fisher55rus/Invertor/Fragments/Литра1.jpg

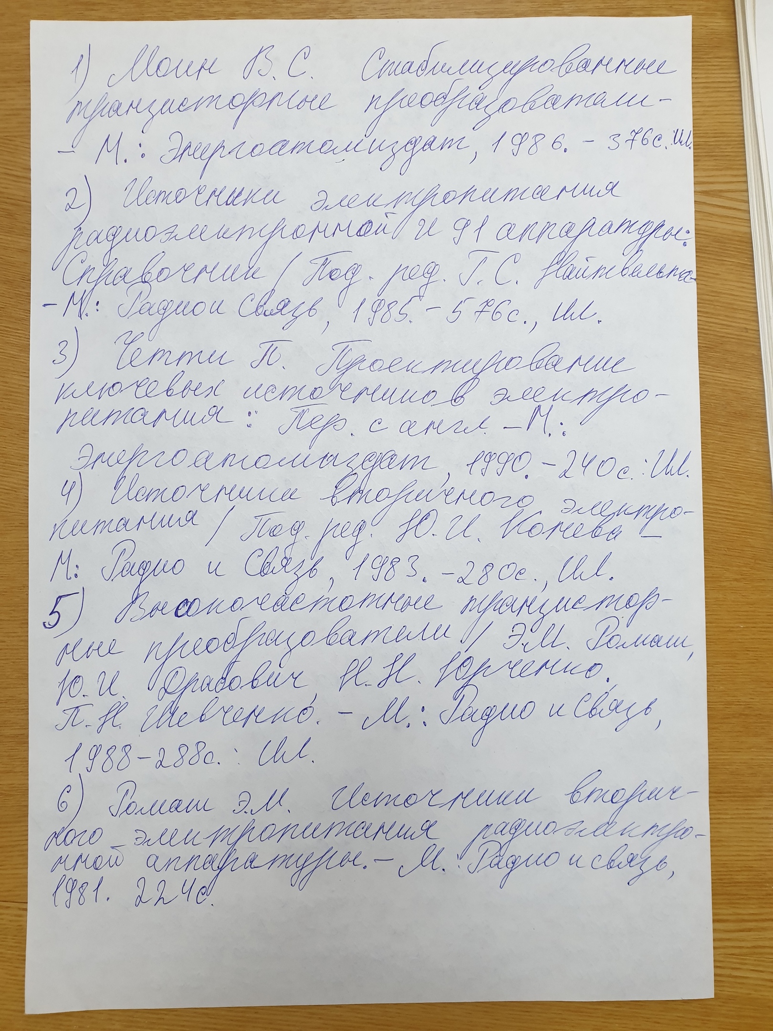
Fragments/Литра1.jpg
