fisher55rus/Invertor/Fragments/Литра2.jpg

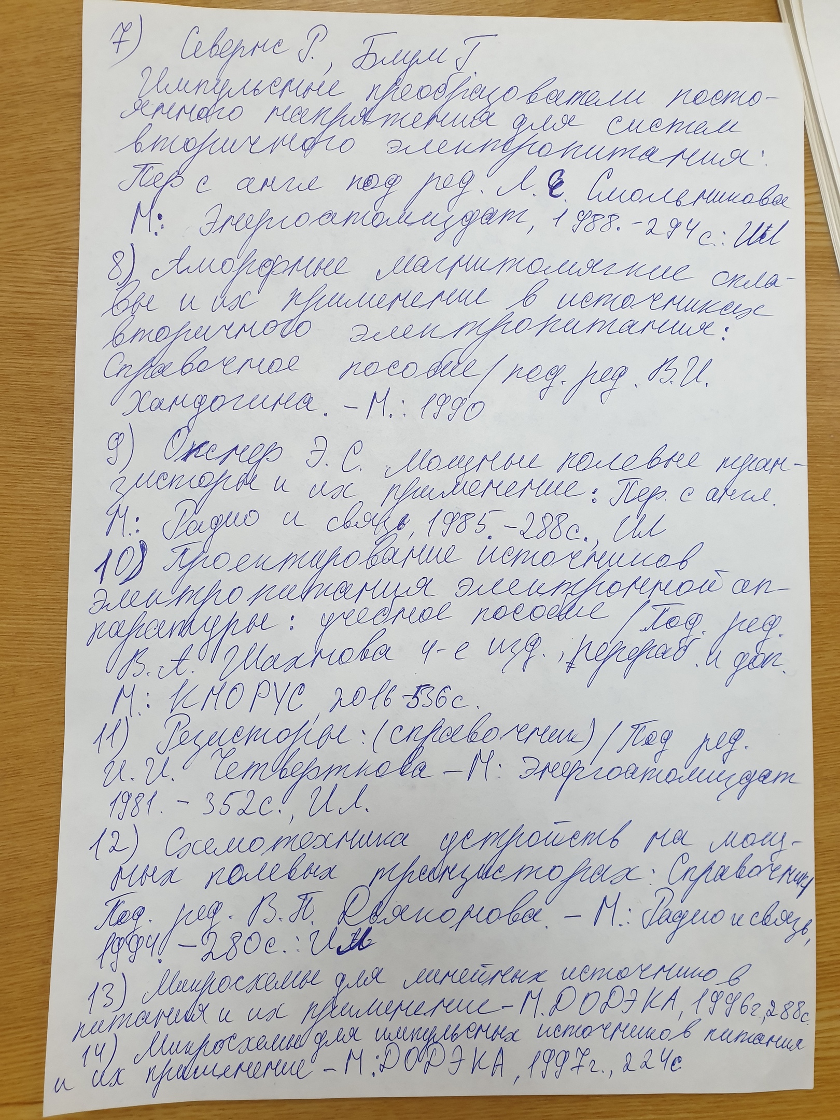
Fragments/Литра2.jpg
