fisher55rus/Invertor/template/main.pdf

Оглавление

Разработка структурной схемы однофазного транзисторного инвертора с гальванической

Список терминов и сокращений

ВЧ трансформатор – Высокочастотный трансформатор НЧ трансформатор – Низкочастотный трансформатор ИВЭП – Источник вторичного электропитания
БВН – Блок вспомогательного напряжения
ДВН – Датчик выходного напряжения
СУЗ – Схема управления и защиты
ДТ – Датчик тока
ИОСН – Источник опорного синусоидального напряженния РНП– Регулятор напряжения питания
РИУ – Регулятор импульсного управления
УСР – Усилитель сигнала рассогласования ОС – Обратная связь

Введение

Возрастающие требования к функциональным возможностям, экономичности и надежности летательных аппаратов диктуют необходимость разработки и внедрения автоматизированных бортовых комплексов,
использующих | новейшие | достижения | силовой | электроники | и
микроэлектроники. В области авиационного электрооборудования - это системы, основанные на преобразовании и распределении электрической
энергии | с | помощью | полупроводниковых | ключей.
В составе таких комплексов важное место отводится инверторам.

Инвертор – Один из видов ИВЭП. Устройство для преобразования постоянного напряжения в выходное переменное. При построении инвертора в приоритете повышение КПД и уменьшение потерь.

Требования к инвертору:

- Инвертор должен иметь высокий КПД
- Инвертор должен уменьшать потери
- Инвертор должен обладать высокой надежностью
- Инвертор должен обладать приемлемыми массо-габаритными характеристиками
- Инвертор должен иметь допустимое значение коэффициентов гармоники

Классификация инверторов:

1. Однофазные:
- С гальванической развязкой:
- С ВЧ трансформатором
- С НЧ трансформатором
-Без гальванической развязки
2. Трехфазные
3. С управлением по напряжению
4. С управлением по току
5. С ШИМ регулированием
6. С РИМ регулированием
7. С аналого-цифровым управлением
8. С микроконтроллерным управлением
9. Одноуровневые
10.Многоуровневые
11.Транзисторные
12.Терристорные

Выбор зависит от конкретных исходных данных и требований. Каждый из перечисленных типов инверторов имеет свои “плюсы” и “минусы”.

Исходя из технических требований, так как в приоритете работы инвертора повышение КПД и снижение потерь, сделан инвертор в ключевом режиме с импульсным методом преобразования.

В процессе создания пришлось использовать сглаживающие силовые фильтры ФНЧ. Благодаря им удалось пропустить первую гармонику, а остальные профильтровать (подавить).

Разработка структурной схемы однофазного транзисторного инвертора с гальванической развязкой

Исходные данные:

- Uвх = 27 В (18 Вmin-36 Вmax)
- Uвых = 36 В ± 2%
- Pнагр = 250 Вт
- cosφ ≥ 0,8
- Uвых пост ≤ 0,5%
- Ограничение аварийных и переходных токов Pнmax = 1,5*Pнагр
- Коэффициент гармоник Кг ≤ 7%

Алгоритм работы структурной схемы и особенности ее построения

Для переключения ключей СТК используется второй импульсный режим. Ключи включаются по диагонали одновременно и синфазно. Такой алгоритм работы структурной схемы обеспечивает простую схему управления и низкую частоту переключения, что позволяет использовать маленький радиатор и тем самым уменьшить массу устройства.

Фильтр разбит на 2 части. В СТК находится дроссель L, т.к. там большой ток, а перед нагрузкой находится конденсатор С, т.к. там большое напряжение. L фильтра – двухобмоточная.

Структурная схема ивертора

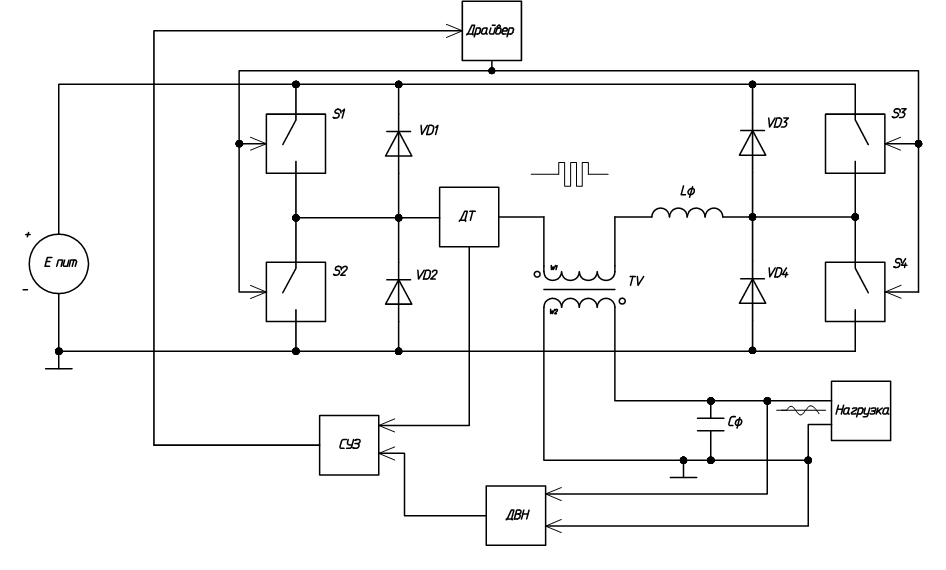
[picture p27: figure]

Рисунок 1 – Структурная схема инвертора

Где :

СУЗ – Схема управления и защиты;

ДВН – Датчик выходного напряжения;

ДТ – Датчик тока.

Разработка функциональной схемы силового каскада

В схеме СТК используются драйверы, которые не требуют подпитки от БВН, это позволяет уменьшить массу устройства.

Из нескольких видов датчиков тока:

- Резистивный
- На эффекте Холла (отечественных датчиков нет)
- Трансформаторный

был выбран последний.

Внутри МДП транзисторов присутствуют паразитные диоды, благодаря им можно обойти без обратных диодов. Но т.к. их параметры плохие, они могут привести к ЭМС и большим потерям. Следовательно, было принято решение поставить диоды шотки. При закрытии транзистора, тока из катушки индуктивности пойдет по пути наименьшего сопротивления через диоды шотки.

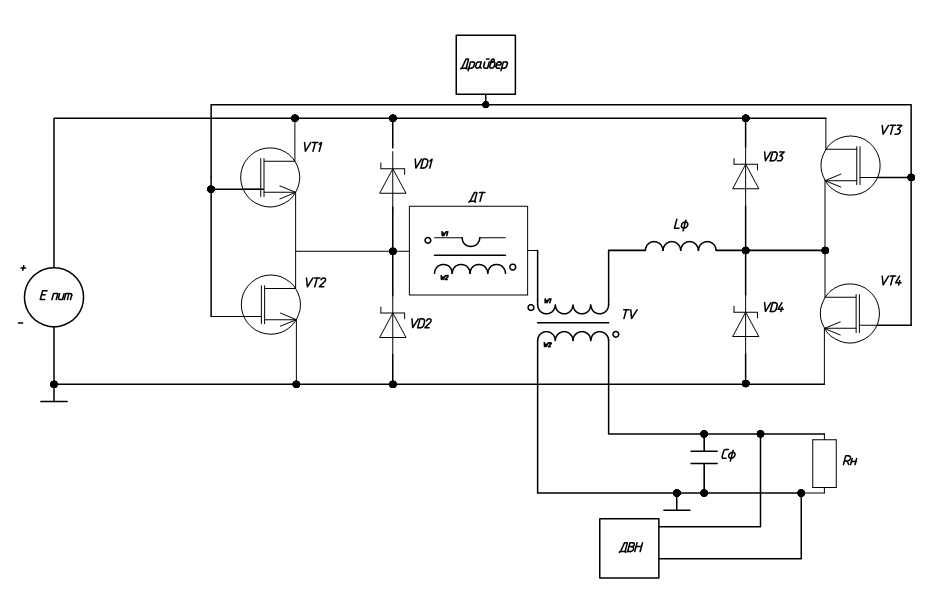
[picture p28: figure]

Рисунок 2 – Функциональная схема СТК

Разработка структурной схемы СУЗ

Существует множество способов построения схемы управления и защиты. В данной курсовой работе был выбран: СУЗ с реллейно-импульсной модуляцией и ограничением по току.

Элементы схемы:

- Сумматор (создает рассогласование напряжения между опорой и синусом)
- Ограничитель напряжения (ограничивает напряжение от -1 до +1)
- Релле (переключает транзисторы)
- ИНСН (дает опорное синусоидальное напряжение)
- ДВН (датчик входного напряжения)

-ДТ (датчик тока)

- УСР (усиливает согнал рассогласования)
- РНП (регулирует напряжения питания)
- РИУ (регулирует импульсное управление)

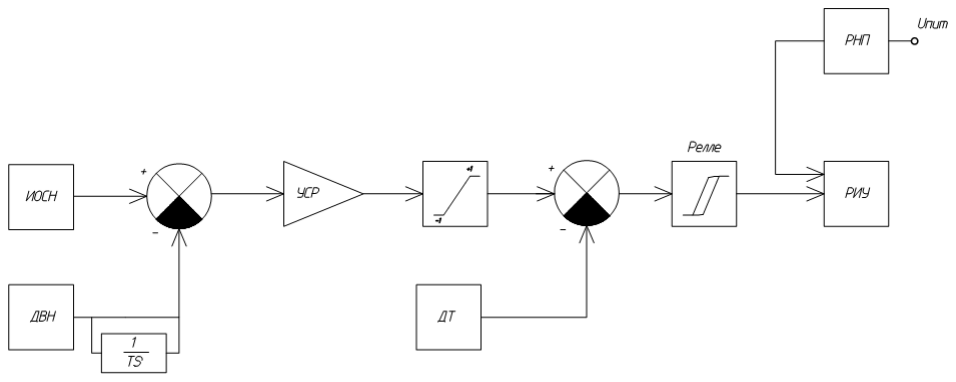
[picture p29: figure]

Рисунок 3 – Структурная схема СУЗ

Построение источника опорного синусоидального напряжения

Есть несколько способов получения ИОСН:

- Однополярный микроконтроллер + схема для второй полярности
- Мультивибратор + фильтр
- Синусный генератор

Был выбран последний вариант.

Из-за того, что ВАХ диода очень зависит от температуры, для схемы выбраны прецезионные и термостабильные диоды.

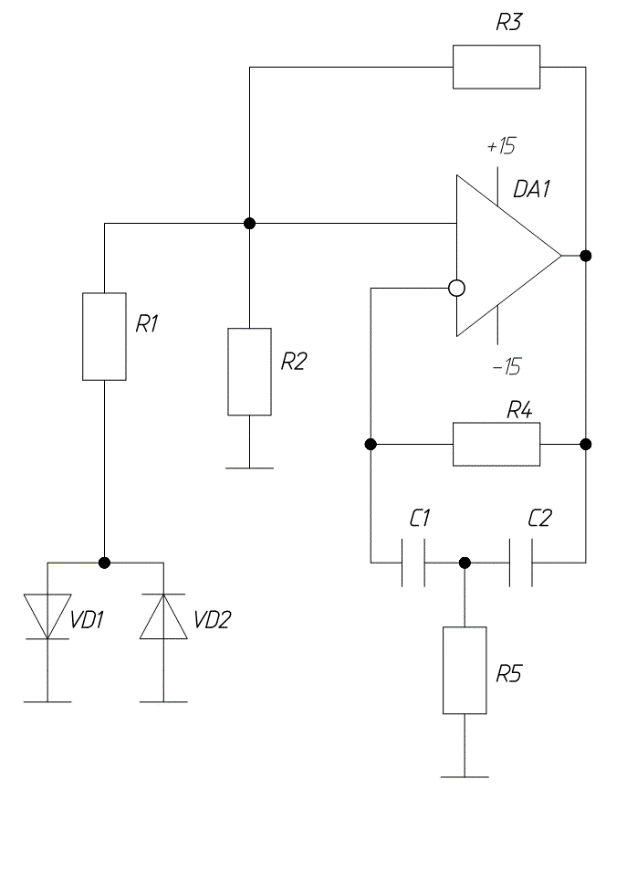
[picture p30: figure]

Рисунок 4 – Схема ИОСН

Математические расчеты

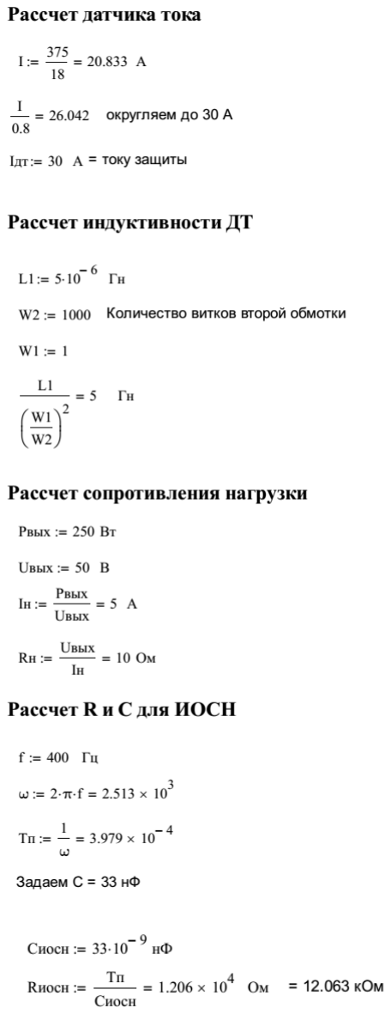
[picture p31: figure]

Моделирование и результаты

В среде Pspice OrCAD была создана модель синусоидального опорного напряжения.

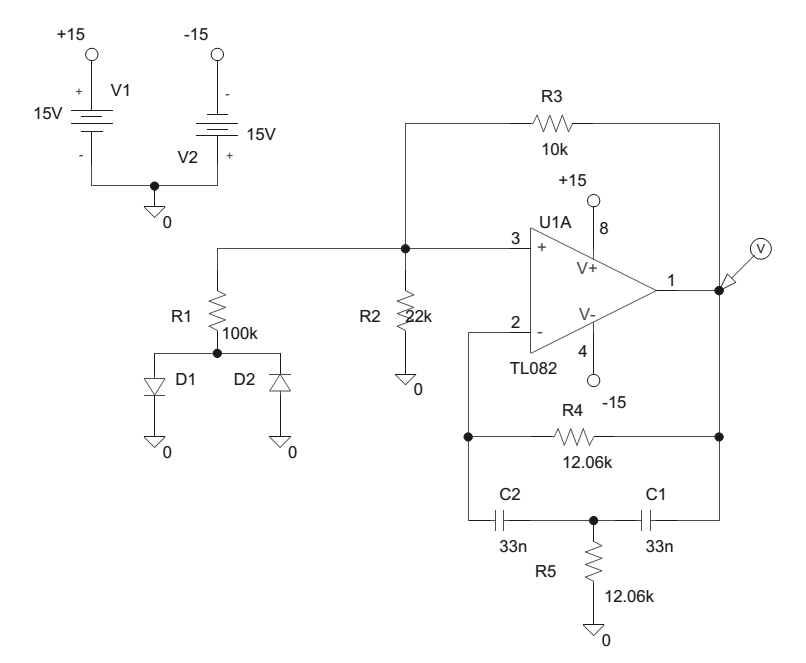
[picture p32: figure]

Рисунок 5 – Схема Pspice источника опорного синусоидального напряжения

ИОСН выполнен как звено с незатухающими синусными колебаниями. Переходные процессы в RC цепочке (R4,C2,C1) образуют синус. При значении коэффициента > 1, колебания будут нарастать, при значении < 1 колебания будут затухать. По этой причине к схеме была пристроена обратная связь. Положительная обратная связь позволяет замкнутой системе работать в режиме генератора. Рассчитанные значения элементов (R1, R2, R3) в ОС умножают коэффициент на 2/3, что и позволяет получить незатухающие колебания.

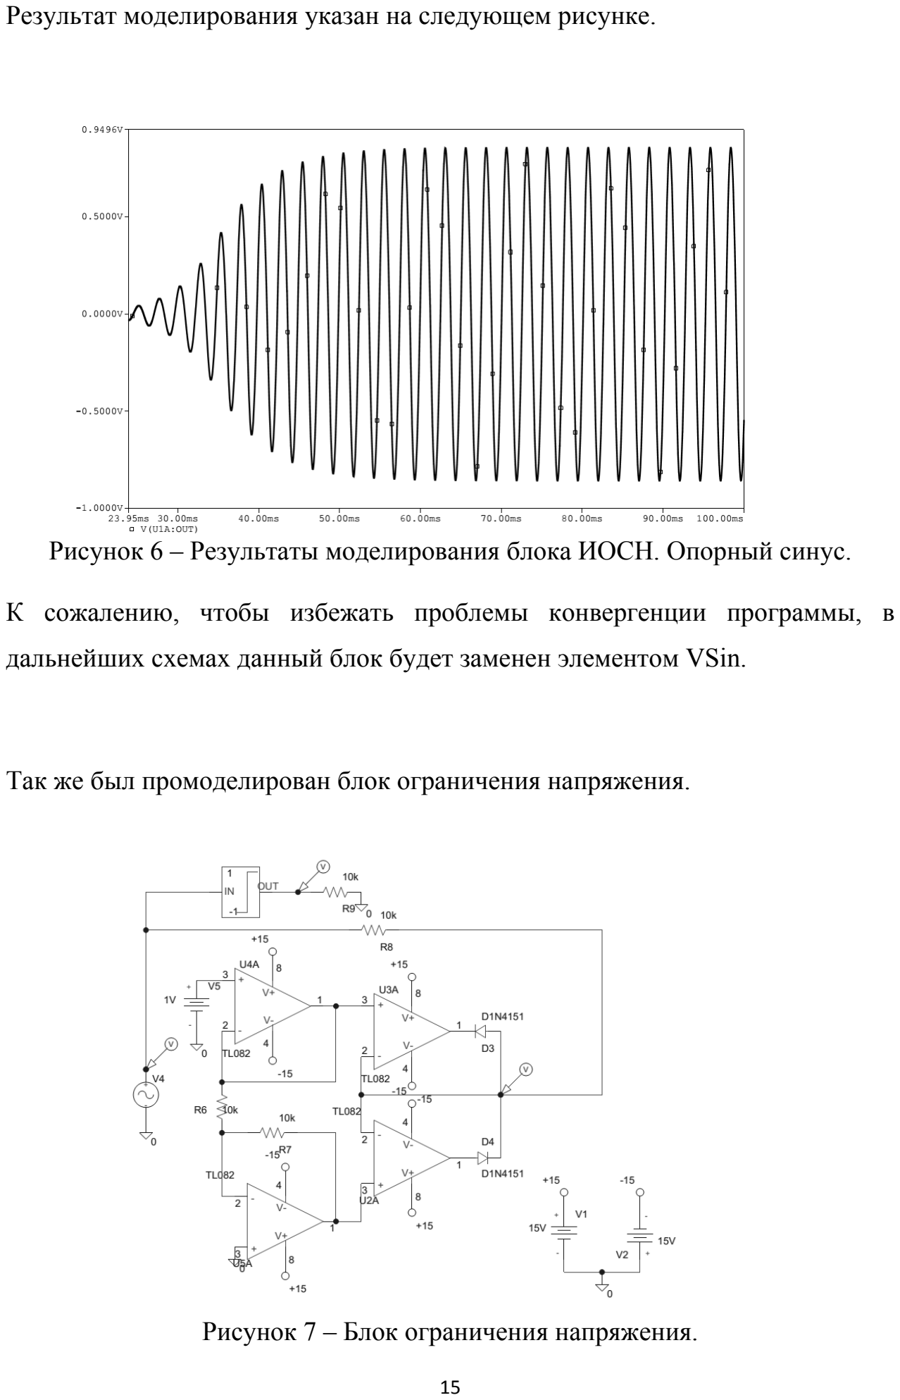
[picture p33: page 15]

Результат моделирования указан на следующем рисунке.

Рисунок 6 – Результаты моделирования блока ИОСН. Опорный синус.

К сожалению, чтобы избежать проблемы конвергенции программы, в дальнейших схемах данный блок будет заменен элементом VSin.

Так же был промоделирован блок ограничения напряжения.

Рисунок 7 – Блок ограничения напряжения.

В данной схеме, микросхемы U4A и U5A создают уровни напряжения +1В и -1В. Они поступают на положительные входы микросхем U3A и U2A, на инверсные входы которых приходит синусоидальный сигнал с элемента VPULSE. При ограничении синусоидального сигнала уровнями “+1В” и “-1В”, получается прямоугольный сигнал, показанный на рисунке 8.

Элемент Limit на представленной схеме выполняет роль проверки. Чтобы сравнить эффективность построенной схемы с готовым элементом. Результаты предоставлены ниже.

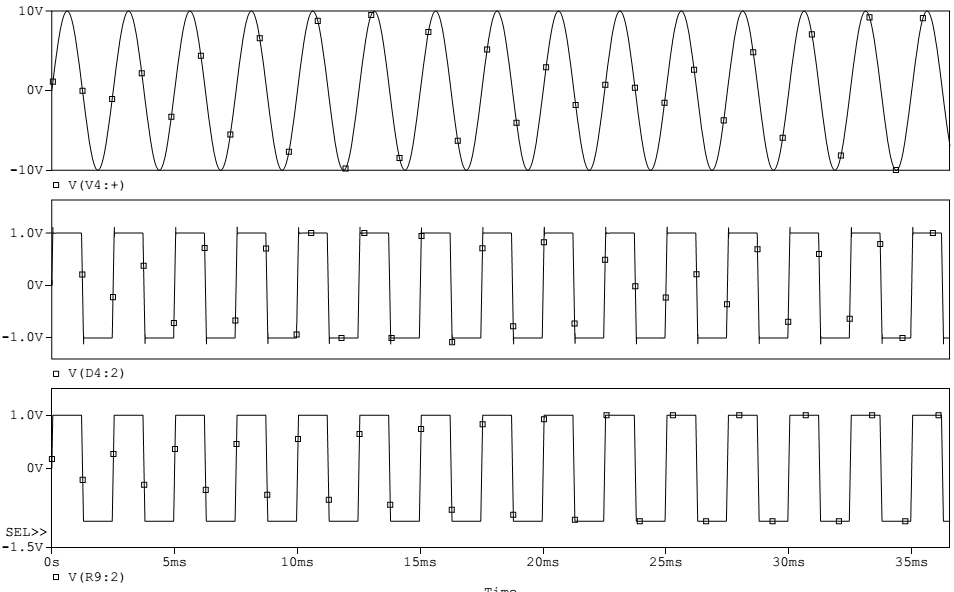
[picture p34: figure]

Рисунок 8 – Результаты моделирования блока ограничения напряжения

На первом графике представлен исходный синус, на втором графике результат ограничения схемой, а на третьем результат ограничения готовым элементом.

Схема работает исправно. Но чтобы исключить появление конвергенции в программе, в дальнейших схемах будет использоваться элемент Limit.

Было решено делать трансформаторный драйвер, т.к. он не требует подпитки от БВН. Такой драйвер выполняет две функции:

- Передача сигнала.
- Передача энергии самоподпитки.

Так же отдельно была создана схема драйвера, не требующая подпитки от БВН.

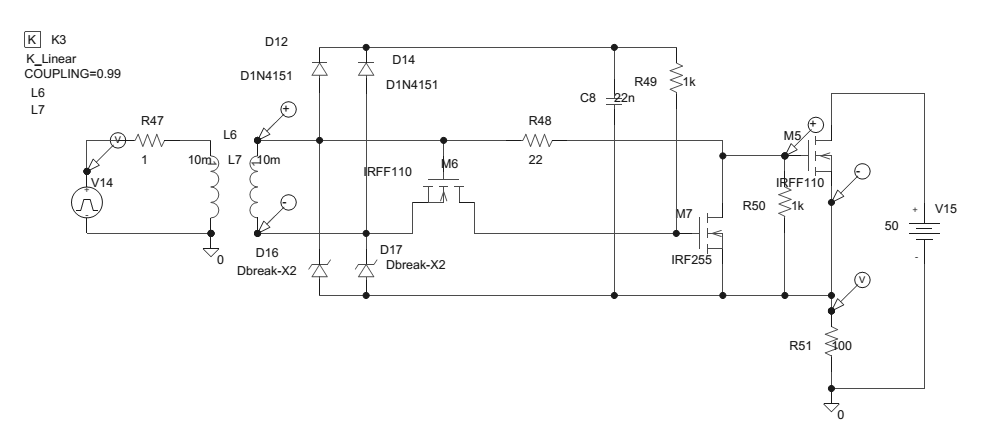
[picture p35: figure]

Рисунок 9 – Схема драйвера без схемы управления

В левой части модели трансформаторного драйвера находится его схема управления, замененная элементом VPULSE. Ток из нее поступает на первичную обмотку трансформатора L6 и не меняясь переносится на вторичную обмотку L7. Сигнал следуя от точки “+” катушки L7 открывает силовой транзистор М5. В момент, когда транзистор СТК будет закрыт, открывается транзистор М7 и ток возвращается через открытый транзистор М6 на точку “-” катушки L7.

На месте диодов D16 и D17, необходимо поставить два стабилитрона. Иначе, при значение COUPLING =0.99 (неидеальная передача), напряжение на силовом транзисторе сильно испортится.

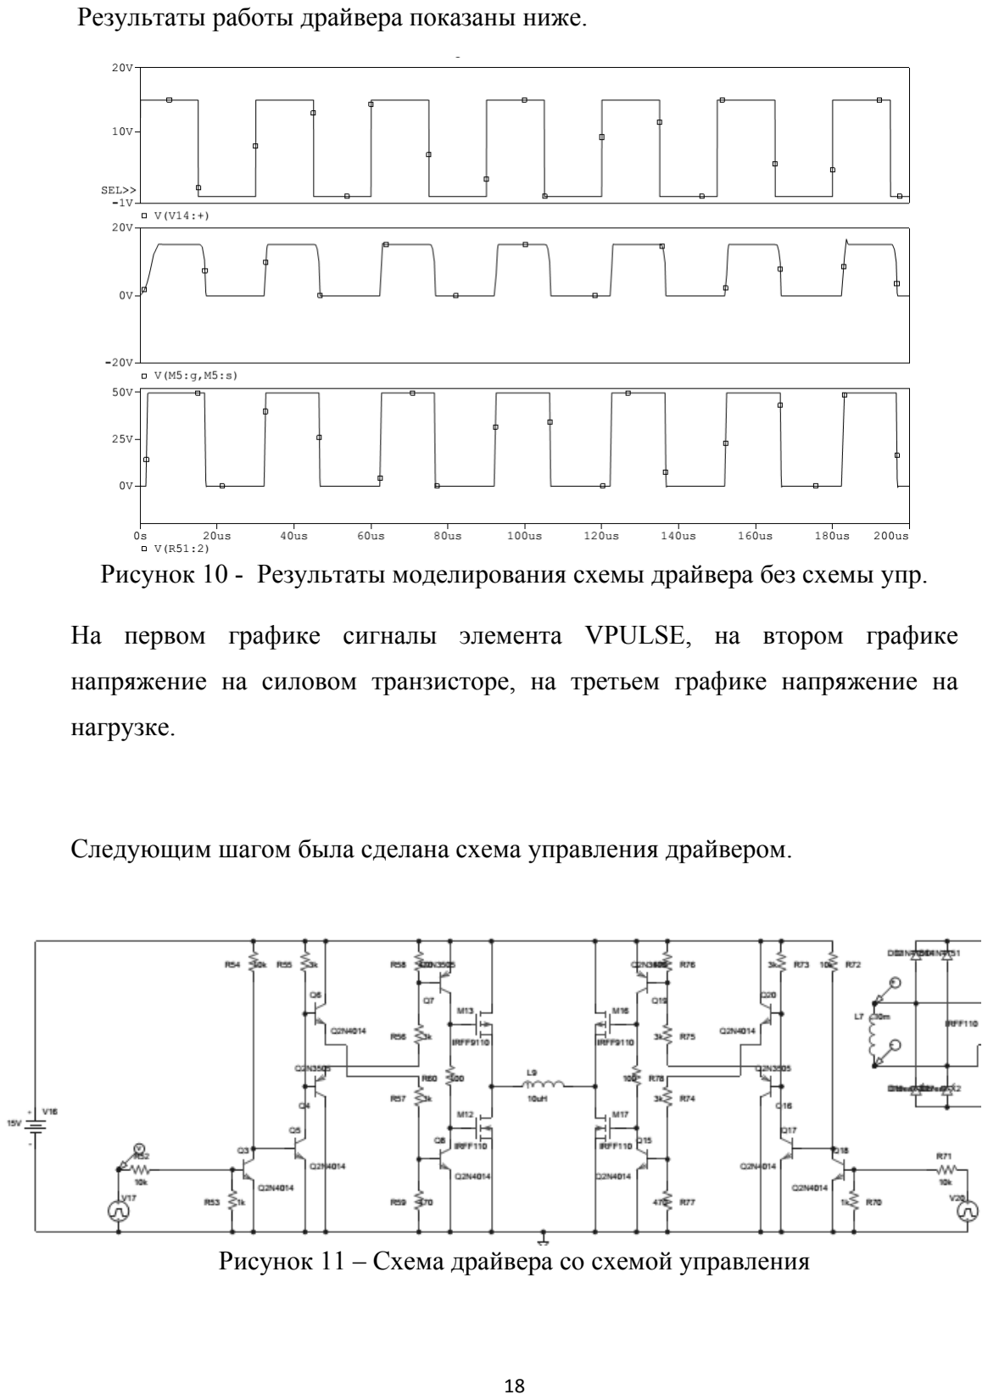
[picture p36: page 18]

Результаты работы драйвера показаны ниже.

Рисунок 10 - Результаты моделирования схемы драйвера без схемы упр.

На первом графике сигналы элемента VPULSE, на втором графике напряжение на силовом транзисторе, на третьем графике напряжение на нагрузке.

Следующим шагом была сделана схема управления драйвером.

Рисунок 11 – Схема драйвера со схемой управления

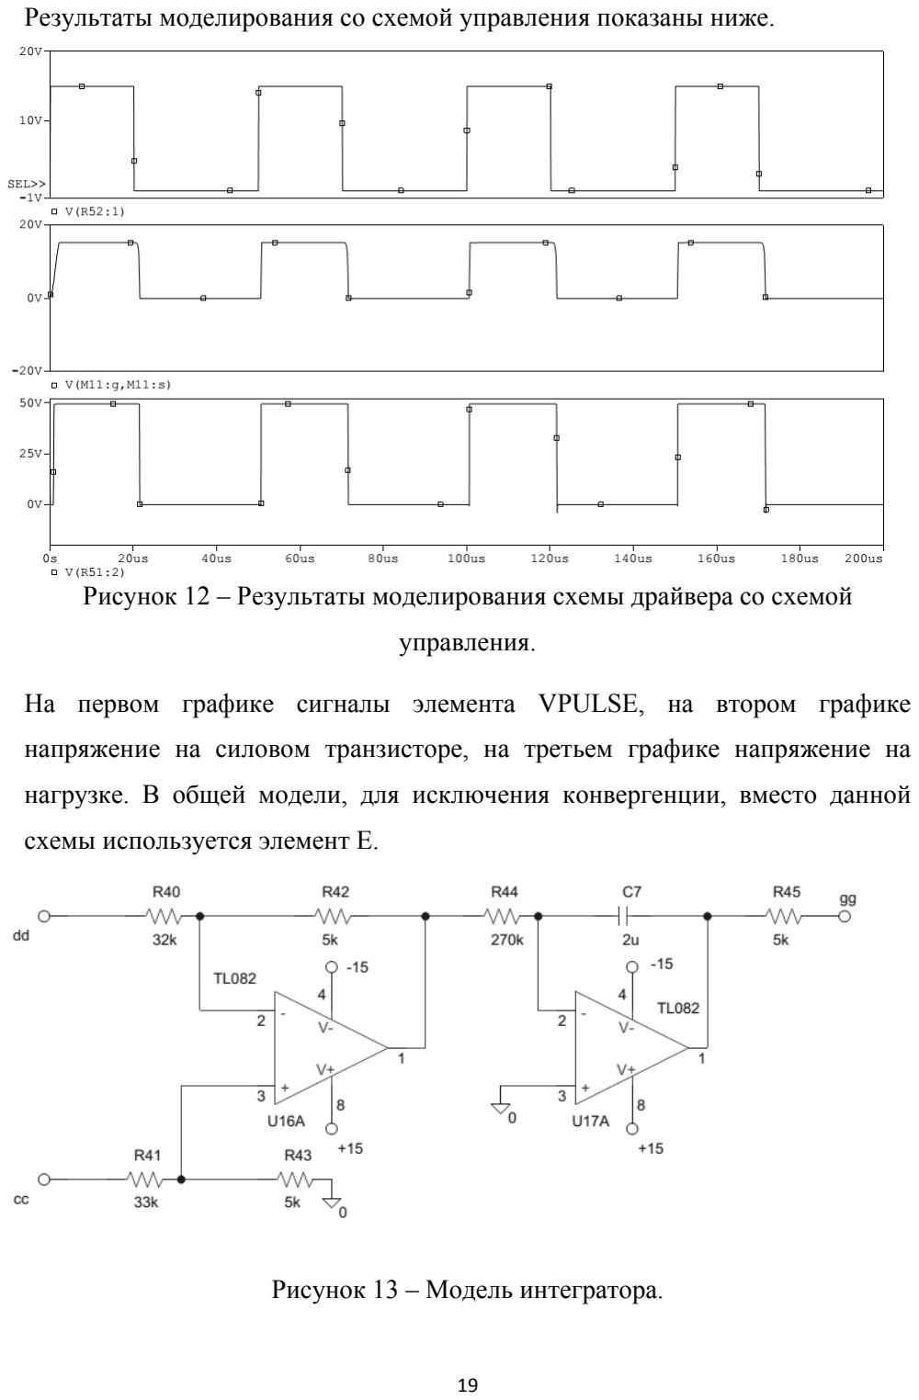
[picture p37: page 19]

Результаты моделирования со схемой управления показаны ниже.

Рисунок 12 – Результаты моделирования схемы драйвера со схемой управления.

На первом графике сигналы элемента VPULSE, на втором графике напряжение на силовом транзисторе, на третьем графике напряжение на нагрузке. В общей модели, для исключения конвергенции, вместо данной схемы используется элемент Е.

Рисунок 13 – Модель интегратора.

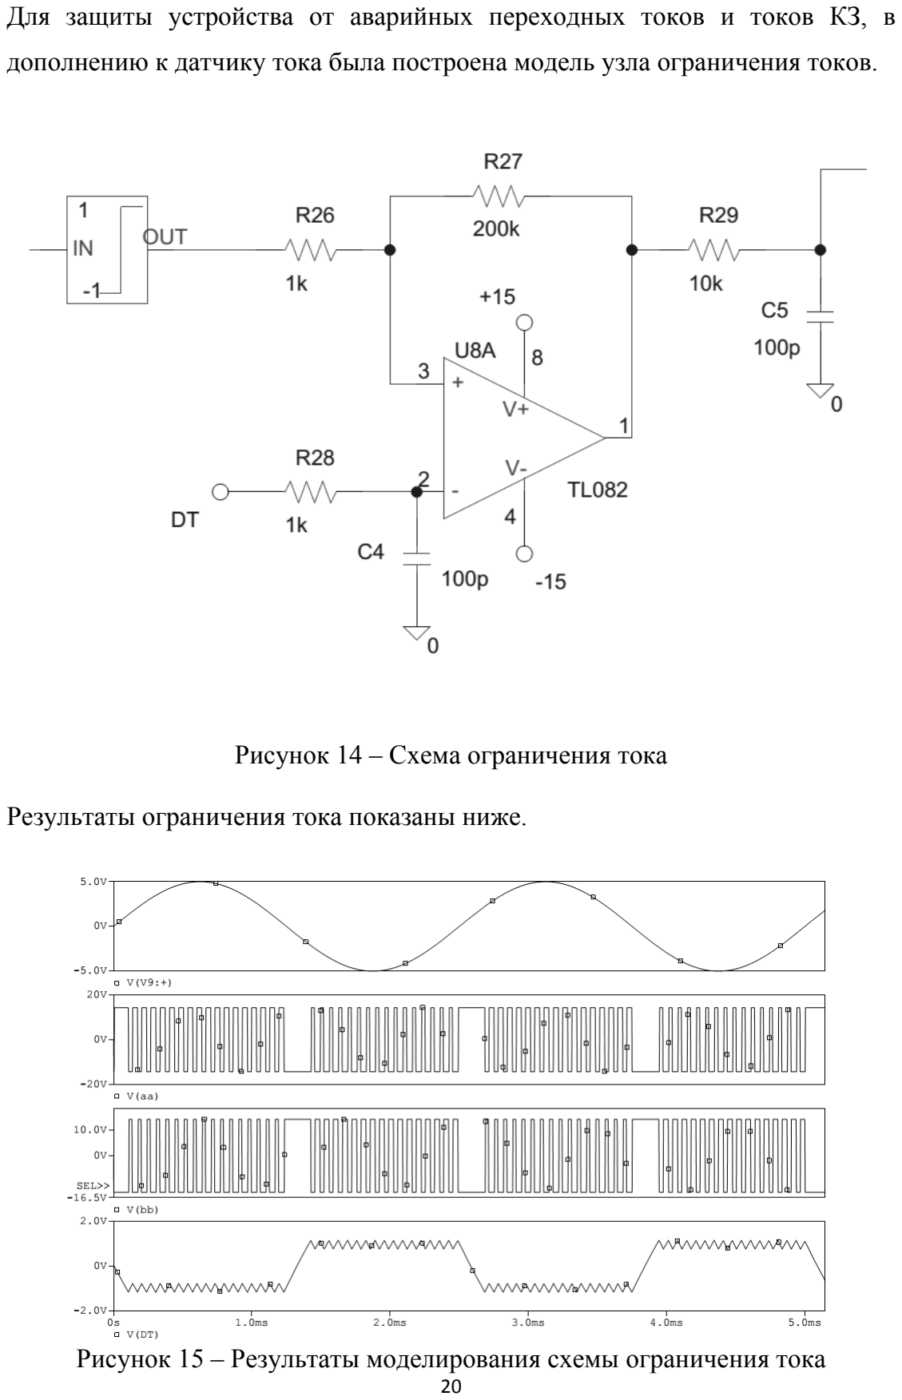
[picture p38: page 20]

Для защиты устройства от аварийных переходных токов и токов КЗ, в дополнению к датчику тока была построена модель узла ограничения токов.

Рисунок 14 – Схема ограничения тока

Результаты ограничения тока показаны ниже.

Рисунок 15 – Результаты моделирования схемы ограничения тока

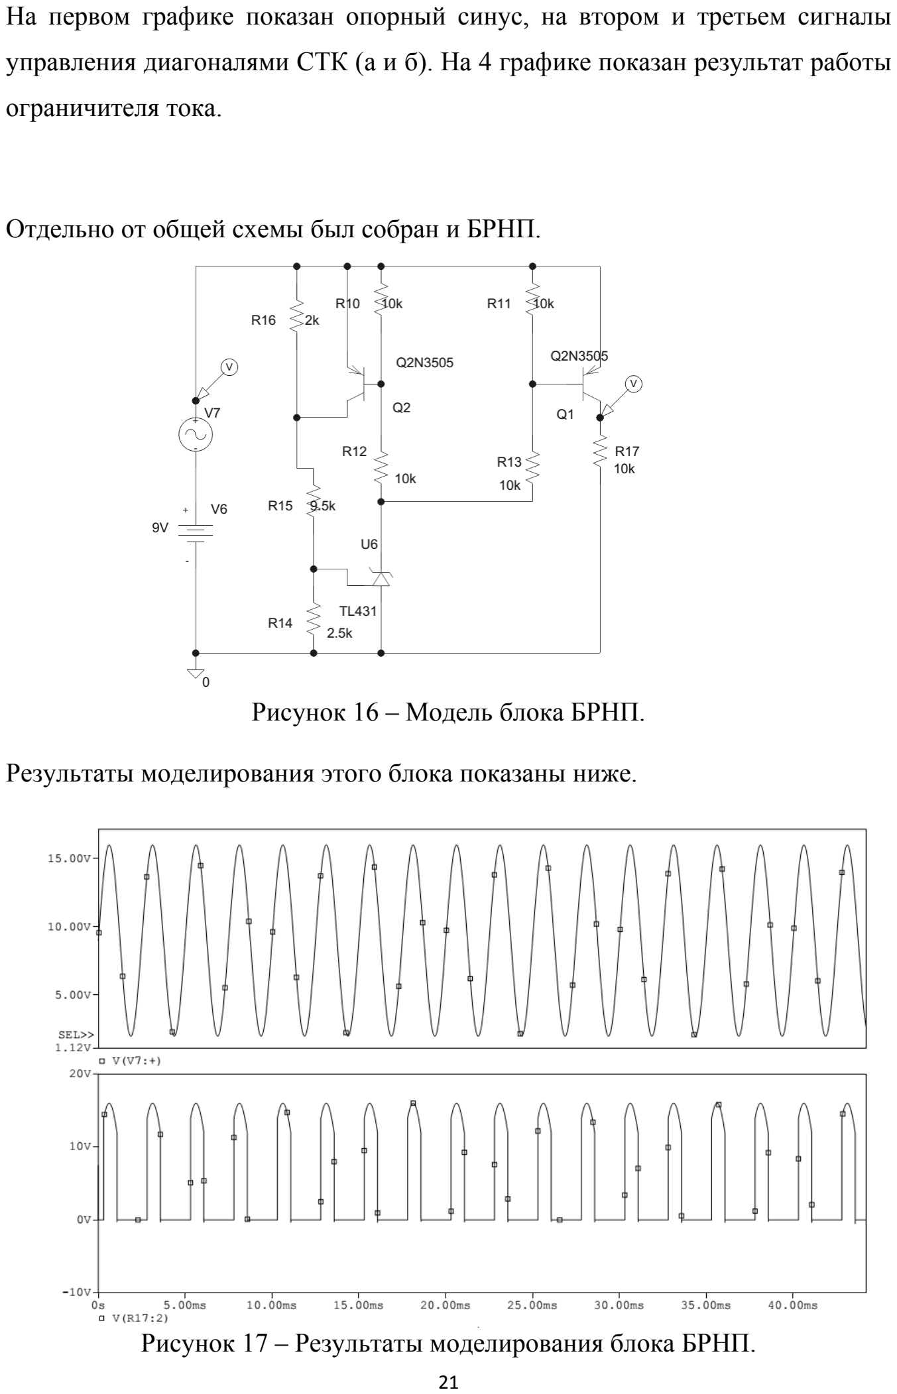
[picture p39: page 21]

На первом графике показан опорный синус, на втором и третьем сигналы управления диагоналями СТК (а и б). На 4 графике показан результат работы ограничителя тока.

Отдельно от общей схемы был собран и БРНП.

Рисунок 16 – Модель блока БРНП.

Результаты моделирования этого блока показаны ниже.

Рисунок 17 – Результаты моделирования блока БРНП.

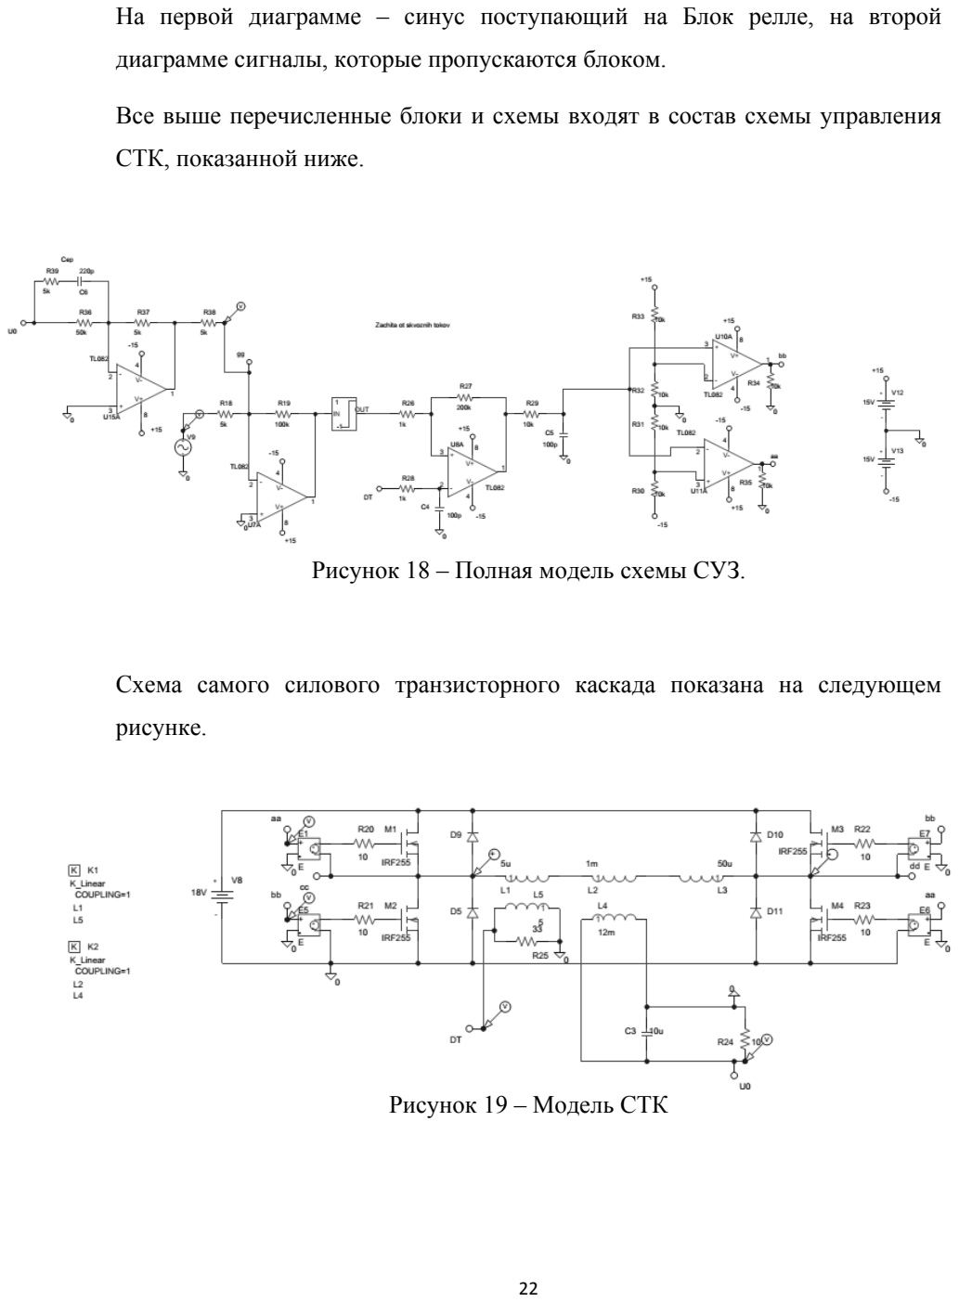
[picture p40: page 22]

На первой диаграмме – синус поступающий на Блок релле, на второй диаграмме сигналы, которые пропускаются блоком.

Все выше перечисленные блоки и схемы входят в состав схемы управления СТК, показанной ниже.

Рисунок 18 – Полная модель схемы СУЗ.

Схема самого силового транзисторного каскада показана на следующем рисунке.

Рисунок 19 – Модель СТК

СТК работает во втором импульсном режиме. Ключи включаются по диагоналям одновременно и синфазно. При открытии транзисторов, ток идет на трансформаторный датчик тока, повышающий трансформатор (ведущий к нагрузке) и сглаживающий фильтр. При закрытии транзисторов, ток из катушки пойдет по пути наименьшего сопротивления через диоды шоттки.

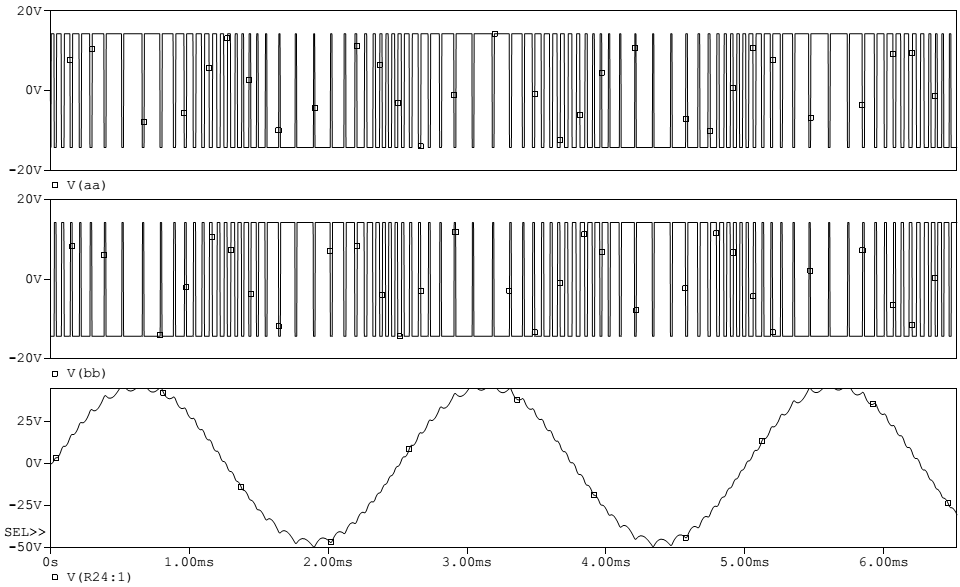
[picture p41: figure]

Рисунок 20 – Результаты моделирования схемы СТК.

Где первые два графика – сигналы управления диагоналями, а третий график – напряжение на нагрузке.

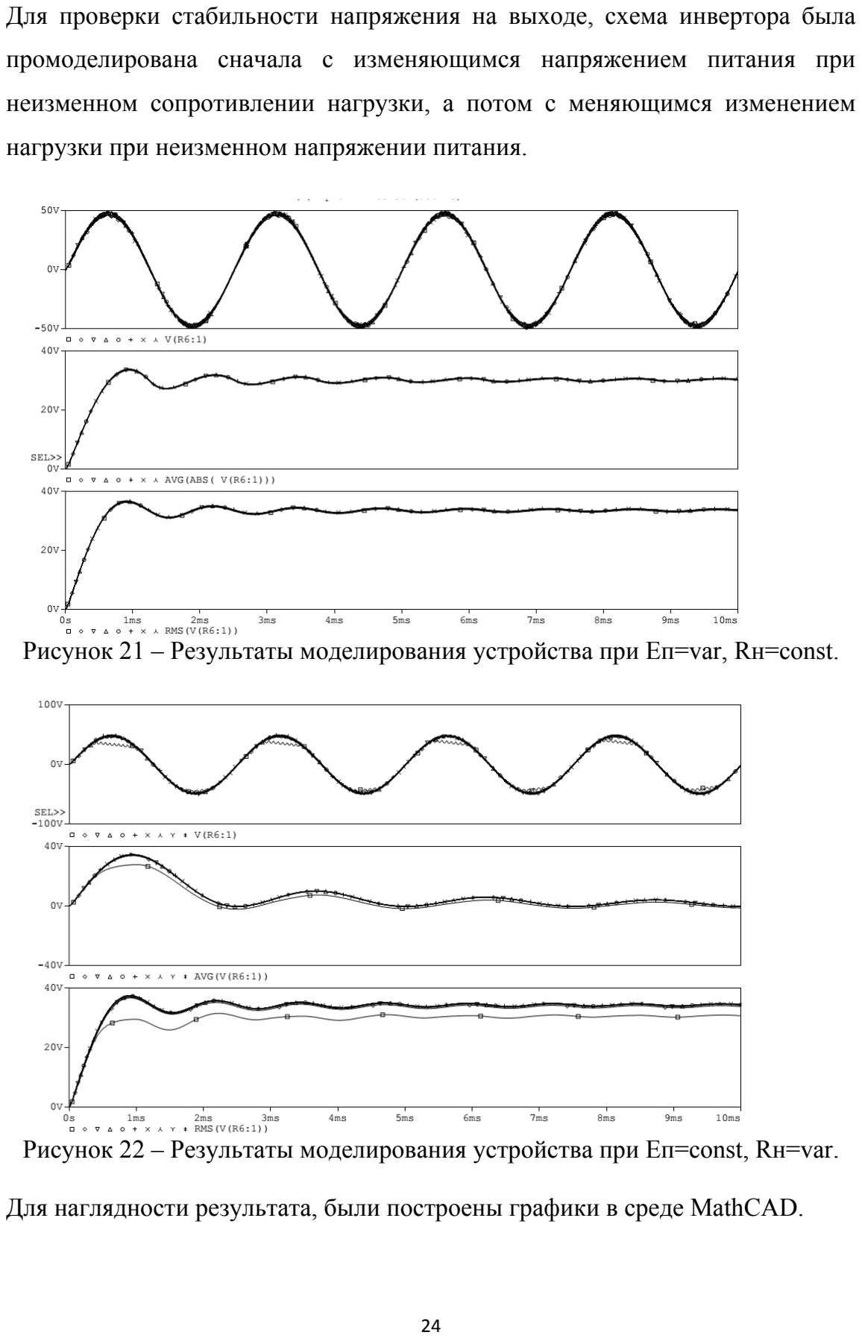
[picture p42: page 24]

Для проверки стабильности напряжения на выходе, схема инвертора была промоделирована сначала с изменяющимся напряжением питания при неизменном сопротивлении нагрузки, а потом с меняющимся изменением нагрузки при неизменном напряжении питания.

Рисунок 21 – Результаты моделирования устройства при Еп=var, Rн=const.

Рисунок 22 – Результаты моделирования устройства при Eп=const, Rн=var.

Для наглядности результата, были построены графики в среде MathCAD.

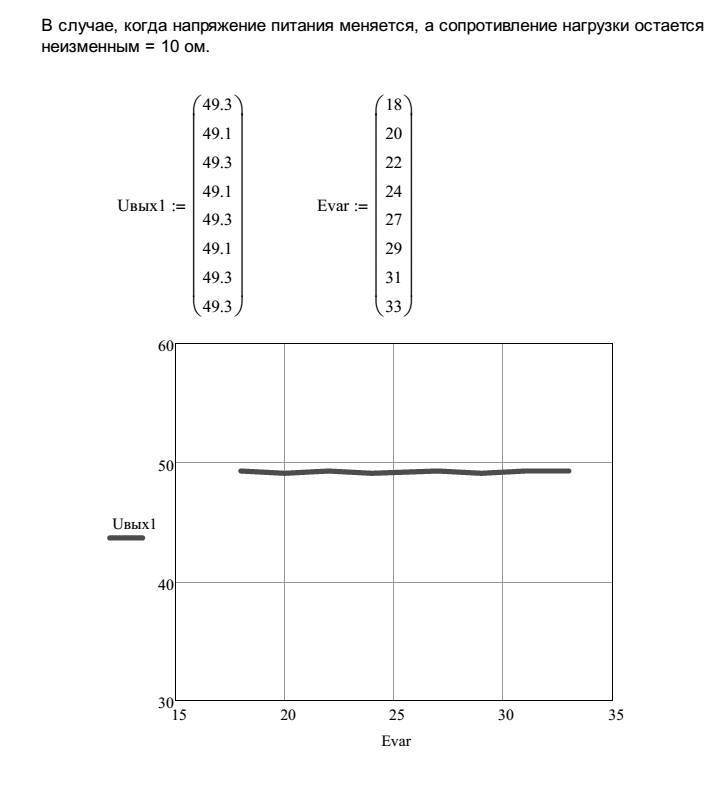
[picture p43: figure]

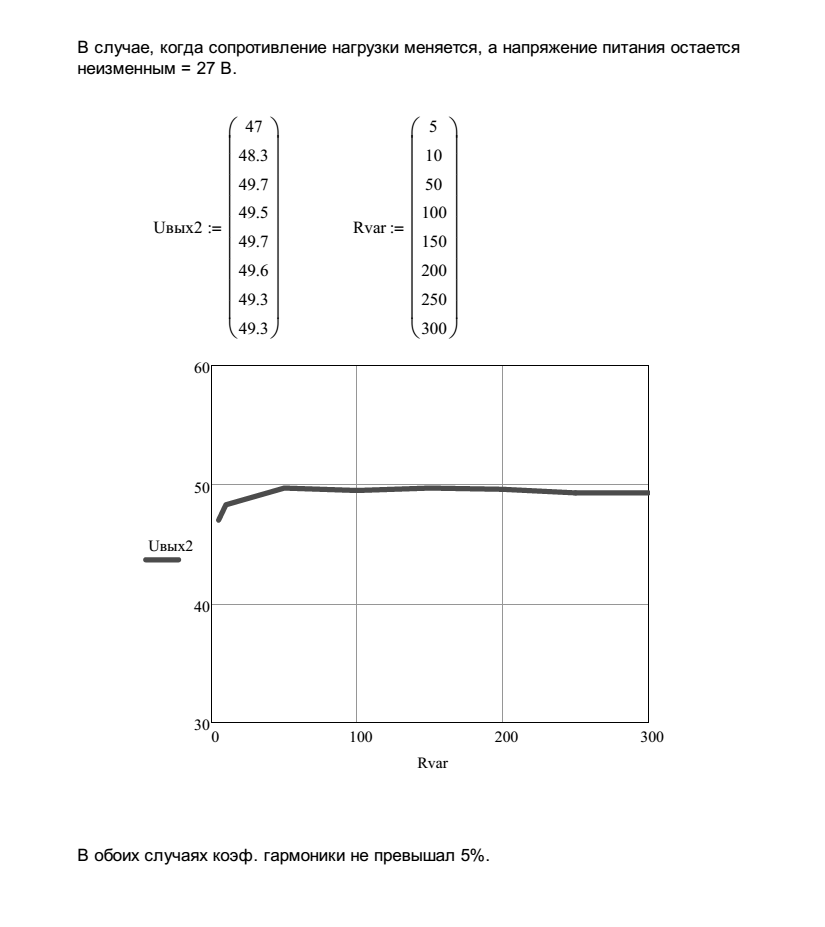
[picture p44: figure]

Перечень элементов

Анализ полученных результатов

В результате проделанной работы, все поставленные задачи по разработке инвертора успешно выполнены.

1) Разработана структурная схема инвертора;
2) Разработан силовой каскад инвертора;
3) Разработана схема управления и защиты инвертора;
4) Разработан источник опорного синусоидального напряжения;
5) Проведен электрический расчет принципиальных электрических схем функциональных узлов инвертора;
6) Разработана компьютерная модель в среде Pspice;
7) Проведено имитационное компьютерное моделирование процессов в инверторе в номинальных, аварийных и переходных режимах;
8) С помощью имитационной компьютерной модели показана работоспособность устройства;
9) Представлены временные диаграммы электро-магнитных процессов, полученные с помощью моделирования.

Перечень используемых источников

1) Моин В.С Стабилизированные транзисторные преобразователи, 1986г.
2) Источники электропитания радиоэлектронной и другой аппаратуры: Справочник под редакцией Т.С. Найтвельта, 1985г.
3) Четти. П. Проектирование ключевых источников электропитания: Перевод с англ.: Энергоатомиздат 1990г.
4) Источники вторичного электропитания (Под редакцией Ю.И. Конева. Радио и связь 1983г.)
5) Высокочастотные трансформаторные преобразователи Э.М. Ромаш, Ю.И. Драбович, Н.Н. Юрченко, П.Н. Шевченко. Радио и связь 1988г.
6) Ромаш Э.М. Источники вторичного электропитания радиоэлектронной аппаратуры. Радио и связь 1981г.
7) Севернс Р., Блум Т. Импульсные преобразователи постоянного напряжения для систем вторичного электропитания. Перевод с англ. Под редакцией Л.Е. Смольникова 1988г.
8) Аморфные магнитомягкие сплавы и их применение в источниках вторичного электропитания. Справочное пособие под редакцией В.И. Хандогина 1990г.
9) Оксмер Э.С. Мощные полевые транзисторы и их применение. Радио и связь 1985г.
10) Проектирование источников электропитания электронной аппаратуры. Учебное пособие под редакцией В.А. Шахмова 4-е издание переработанное и дополненное 2016г.
11) Резисторы (справочник) под редакцией И.И. Четверткова 1981г.
12) Схемотехника устройств на мощных полевых транзисторах. Справочник под редакцией В.П. Двяконова 1994г.
13) Микросхемы для линейных источников питания и их применение ДОДЭКА 1996г.

14) Микросхемы для импульсных источников питания и их применение ДОДЭКА 1997г.
15) Лекции по курсу "Статические преобразователи энергии систем электроснабжения летательных аппаратов".
16) Основы радиоинженерной деятельности Дашкова А.К
17) Проектирование электрооборудования объектов гражданского назначения Макаренко С.И.
18) Аспекты проектрирования электронных схем А.Ч. Моисейкин
19) Переходные процессы в линейных электрических цепях Мякишев В.М.
20) Радиотехника от истоков до наших дней Каганов В.И.
21) Силовая электроника, силовые полупроводниковые преобразователи Онищенко Г.Б.
22) http://meandr.org - ссылка на транзисторы
23) http://chipinfo.pro/element - ссылка на резисторы и диоды.

Отзыв руководителя
