fisher55rus/Invertor/Time_diagramm/1_SK.jpg

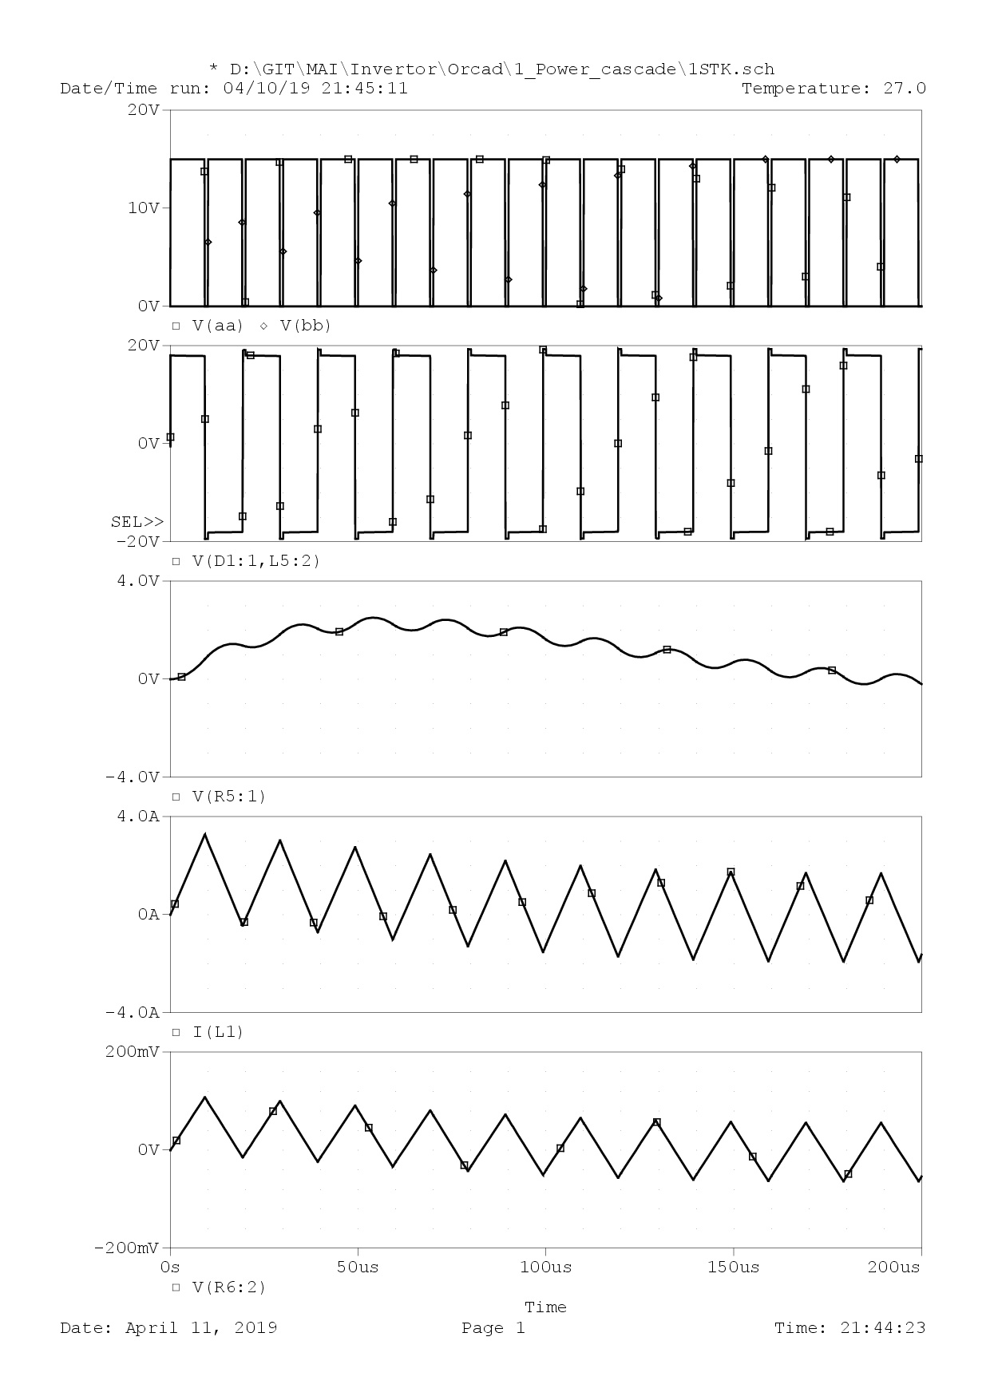
Time_diagramm/1_SK.jpg
