fisher55rus/Invertor/Time_diagramm/2_1_SG_mv.jpg

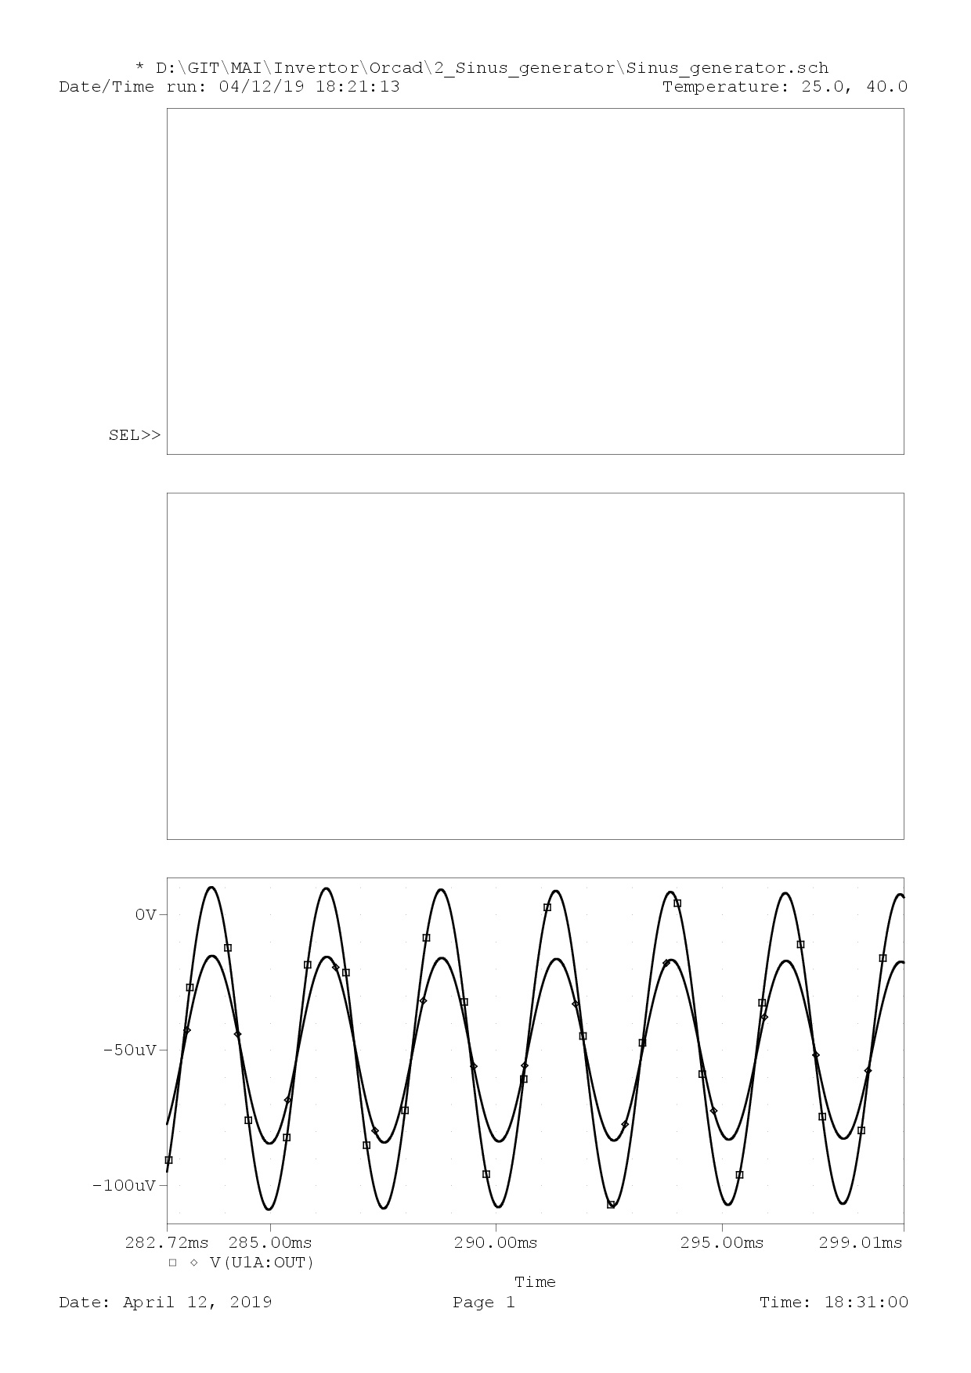
Time_diagramm/2_1_SG_mv.jpg
