fisher55rus/Invertor/Time_diagramm/2_2_Sg_TL431.jpg

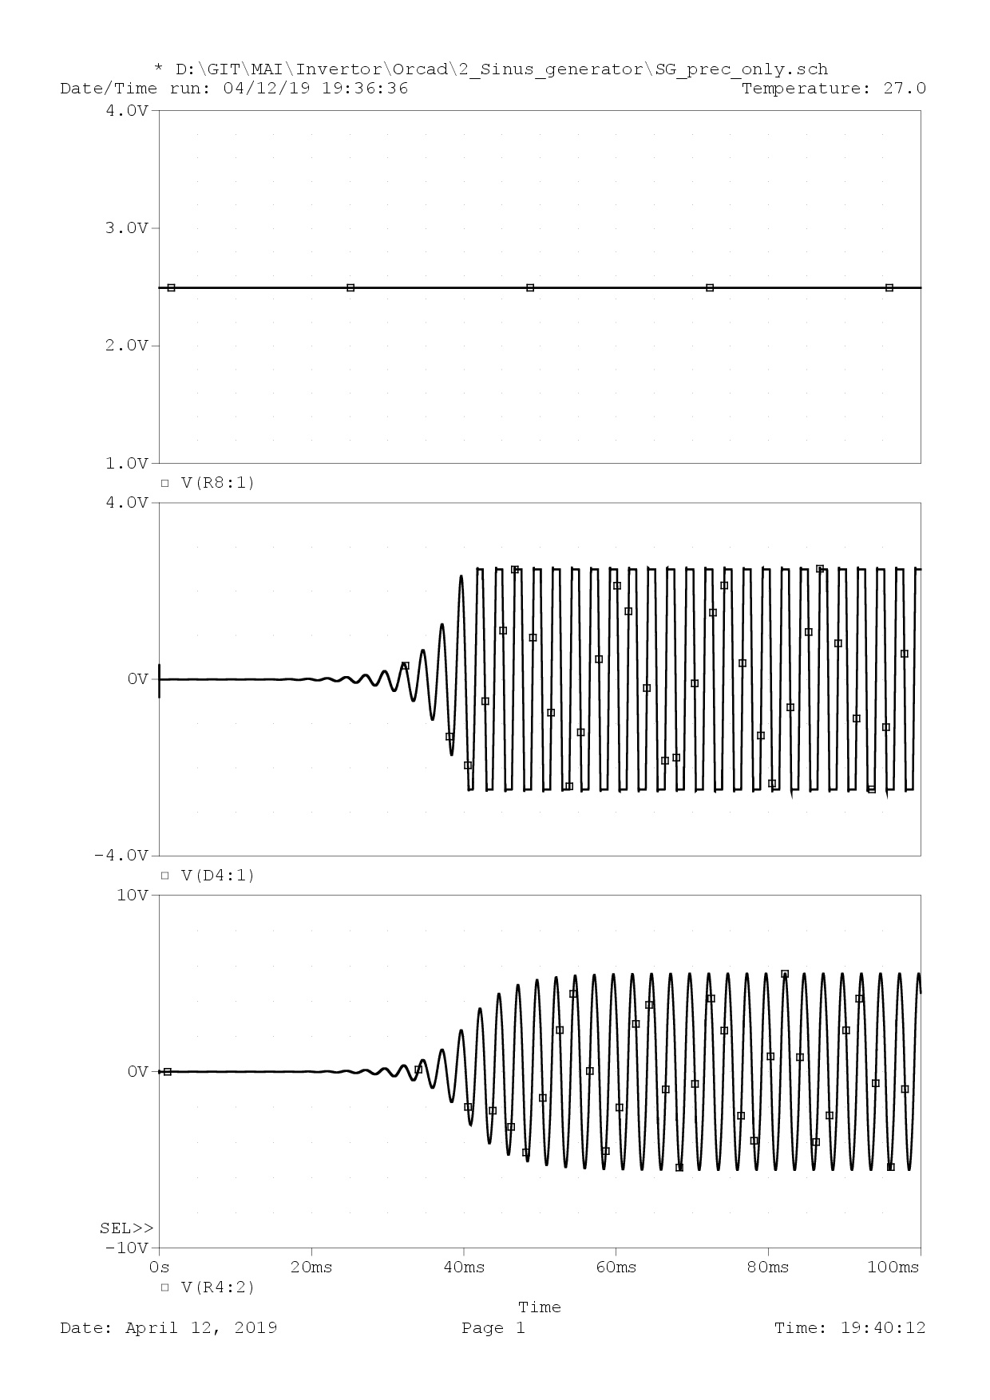
Time_diagramm/2_2_Sg_TL431.jpg
