fisher55rus/Invertor/Time_diagramm/3_Limit.jpg

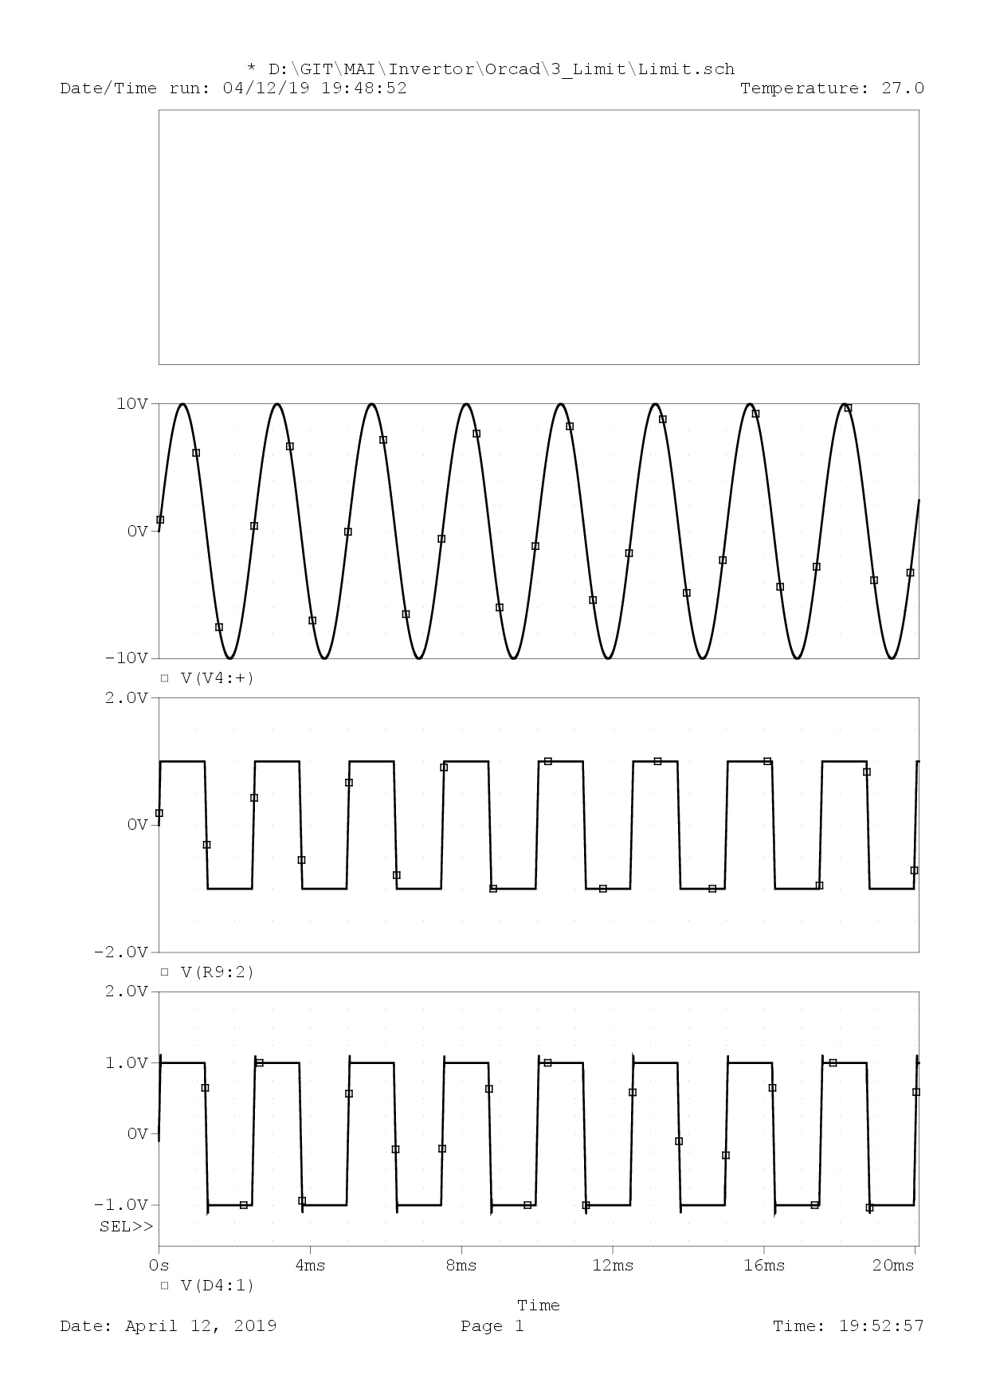
Time_diagramm/3_Limit.jpg
