fisher55rus/Invertor/Time_diagramm/4_RNP.jpg

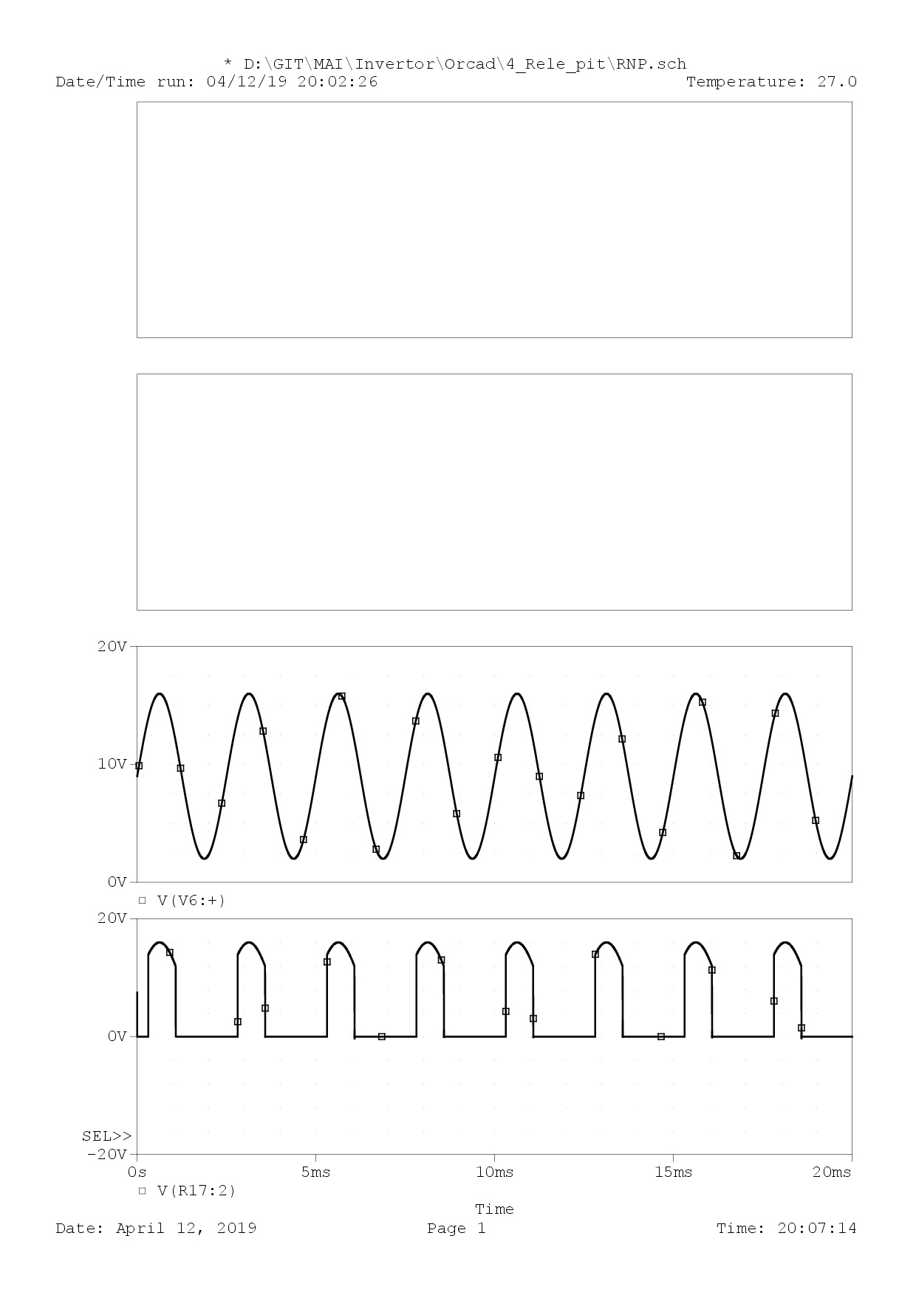
Time_diagramm/4_RNP.jpg
