fisher55rus/Invertor/Time_diagramm/5_driver.jpg

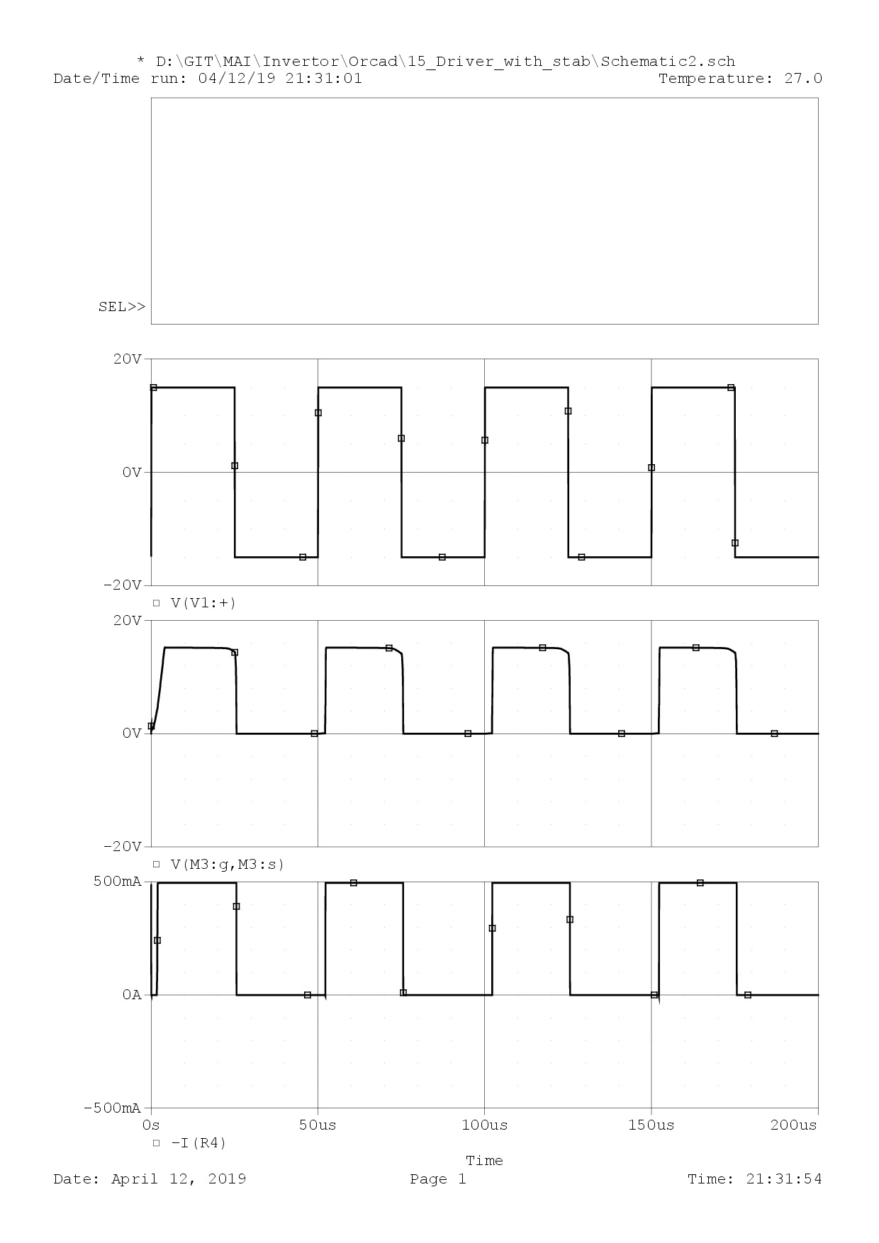
Time_diagramm/5_driver.jpg
