fisher55rus/Invertor/Time_diagramm/6_OS_current (1).jpg

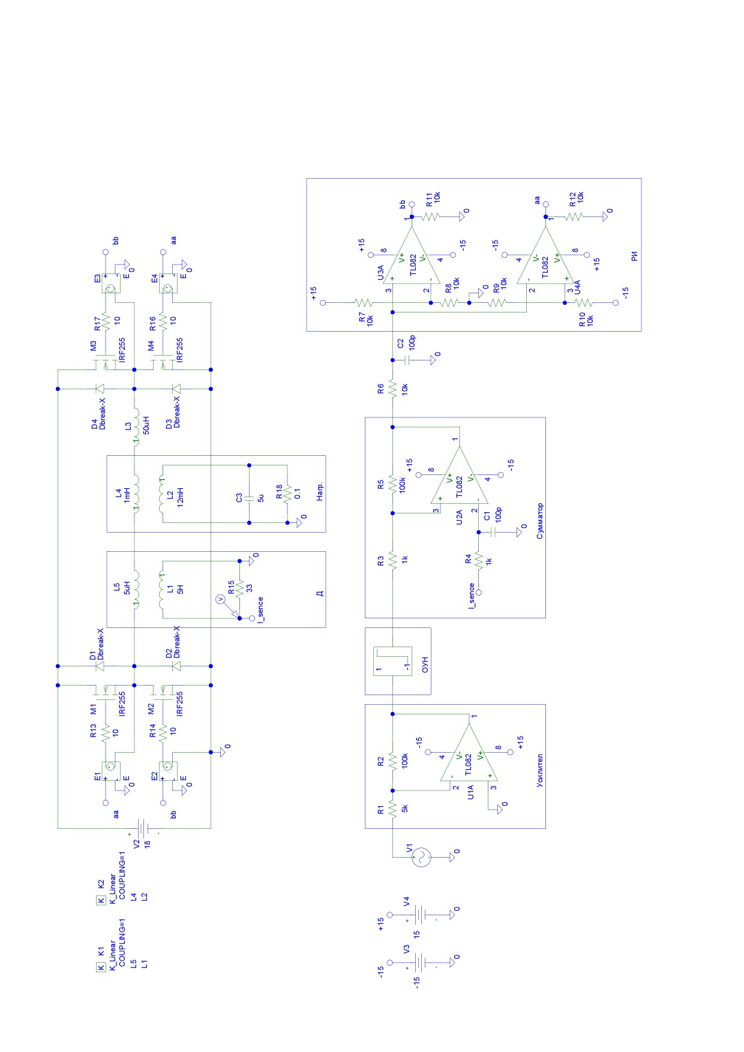
Time_diagramm/6_OS_current (1).jpg
