fisher55rus/Invertor/Time_diagramm/6_OS_current.jpg

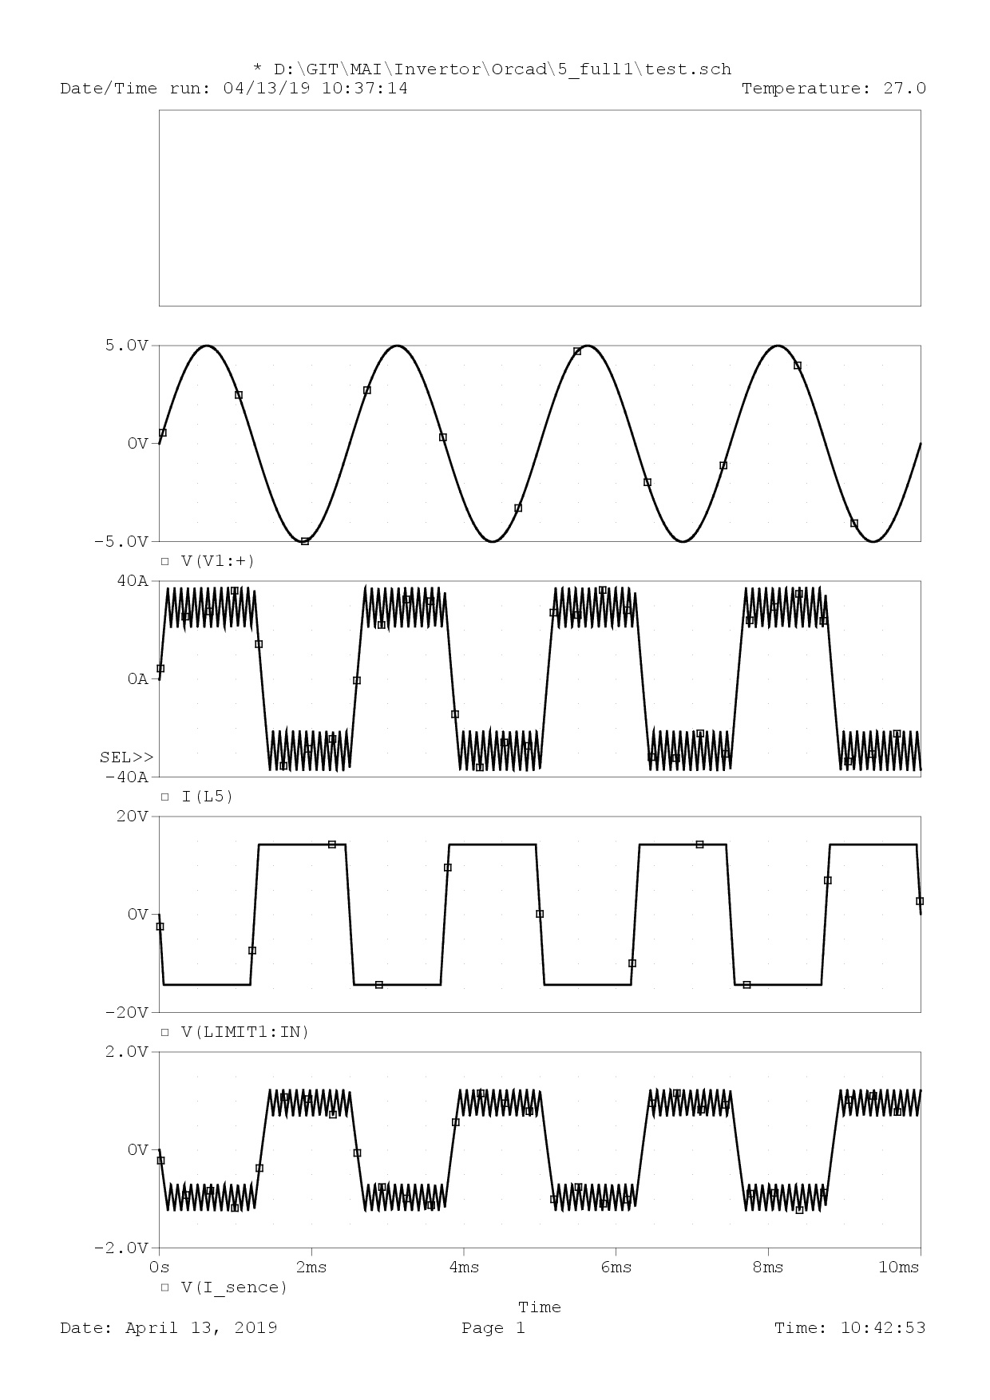
Time_diagramm/6_OS_current.jpg
