fisher55rus/Invertor/Time_diagramm/7_OS_cur_volt (1).jpg

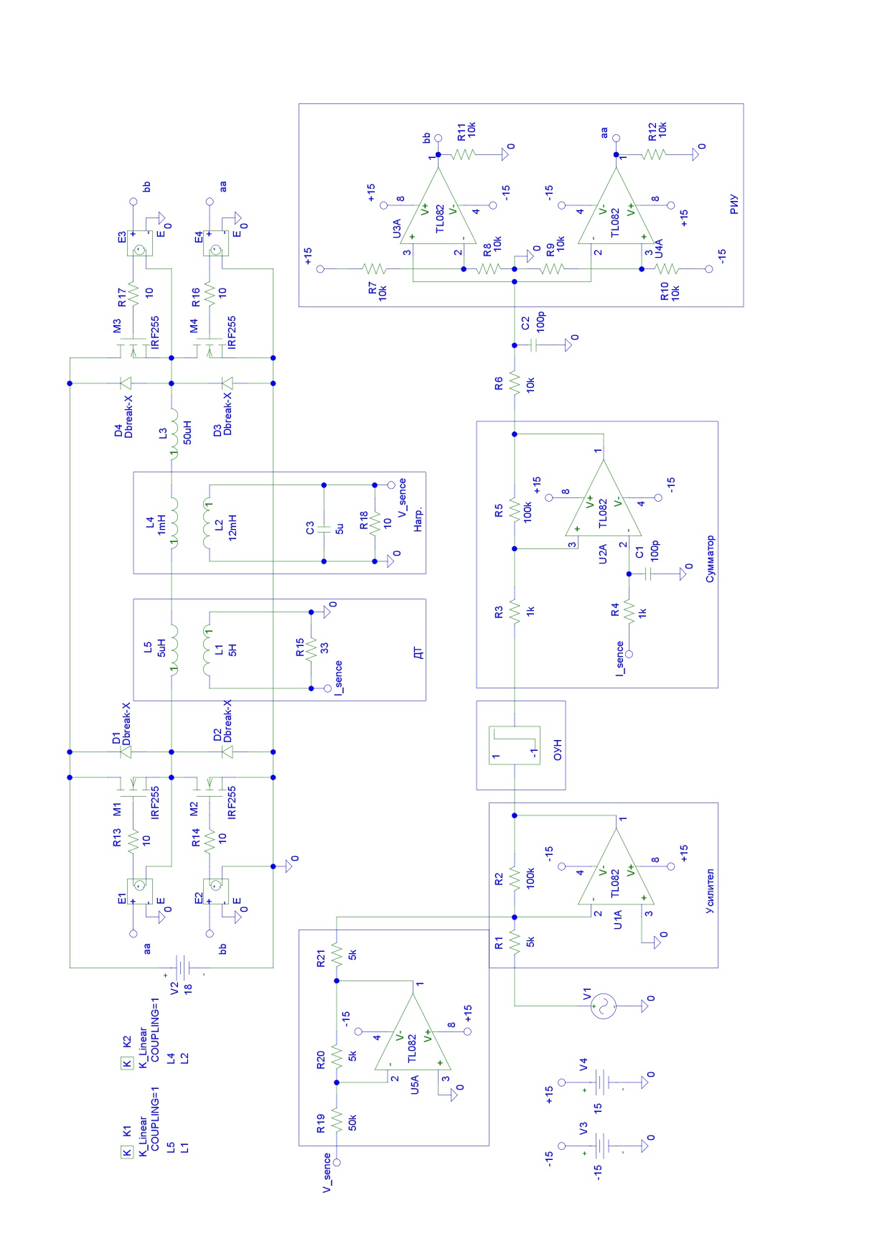
Time_diagramm/7_OS_cur_volt (1).jpg
