fisher55rus/Invertor/Time_diagramm/7_OS_cur_volt.jpg

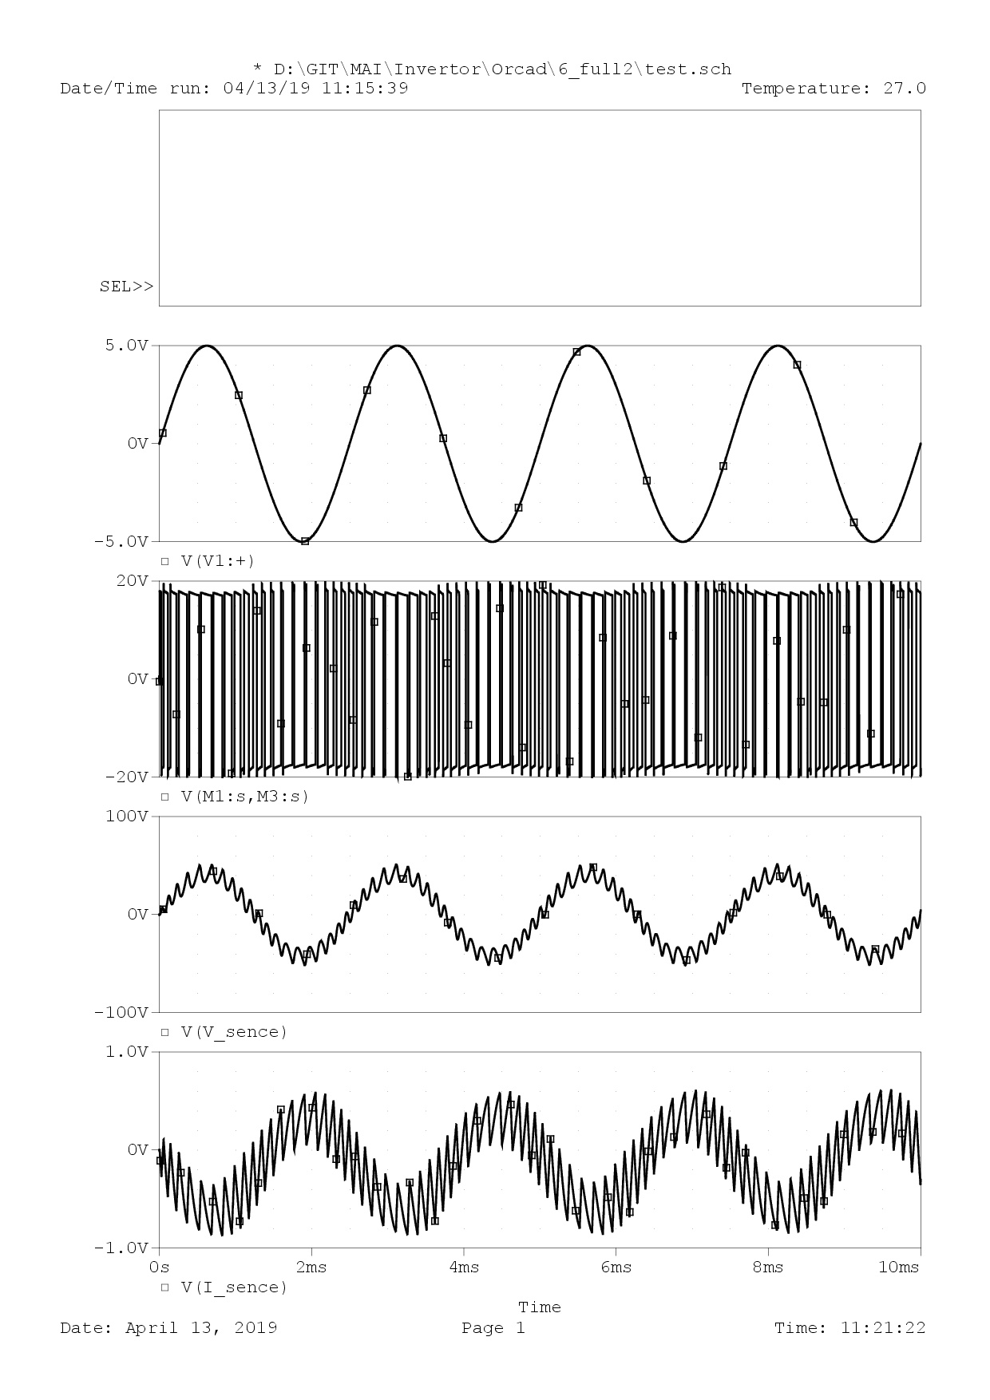
Time_diagramm/7_OS_cur_volt.jpg
