fisher55rus/Invertor/Time_diagramm/8_correction (1).jpg

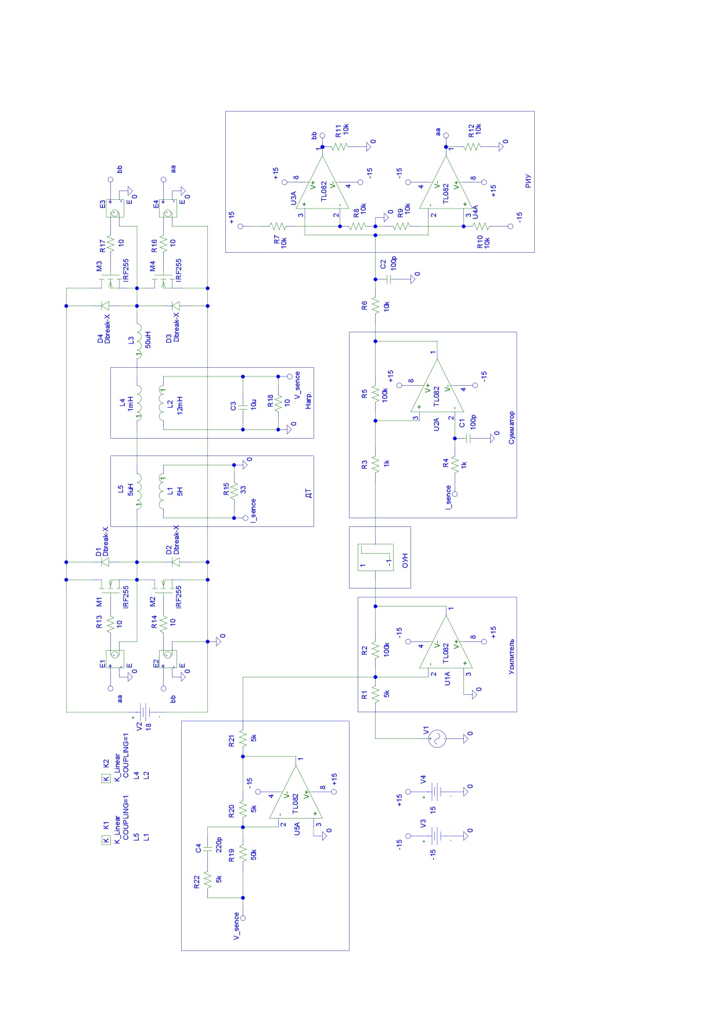
Time_diagramm/8_correction (1).jpg
