fisher55rus/Invertor/Time_diagramm/8_correction.jpg

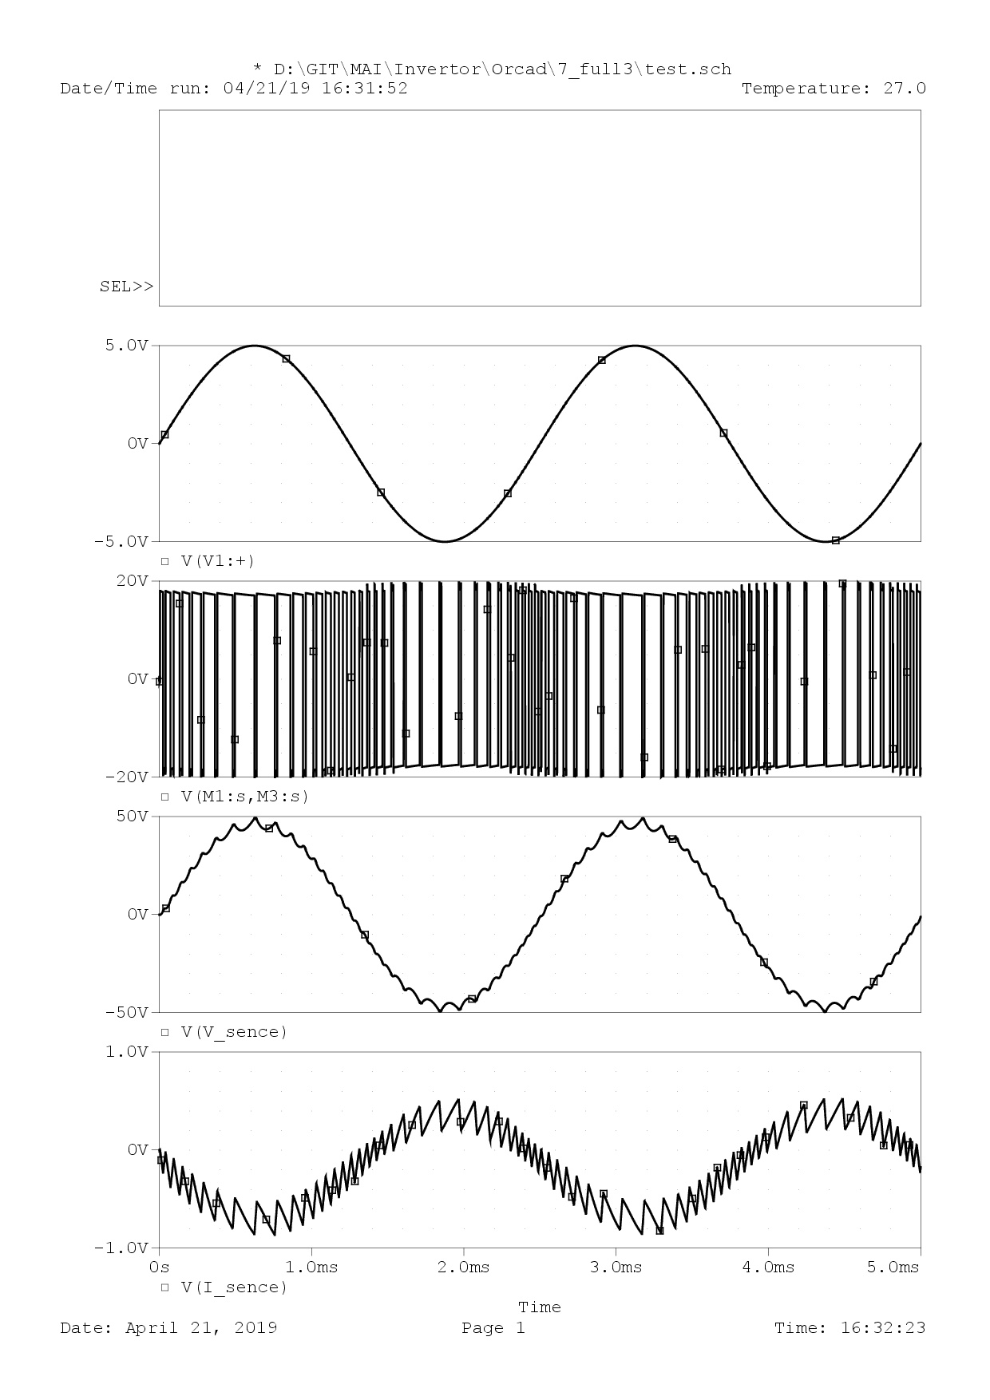
Time_diagramm/8_correction.jpg
