fisher55rus/Invertor/Time_diagramm/9_diodes.jpg

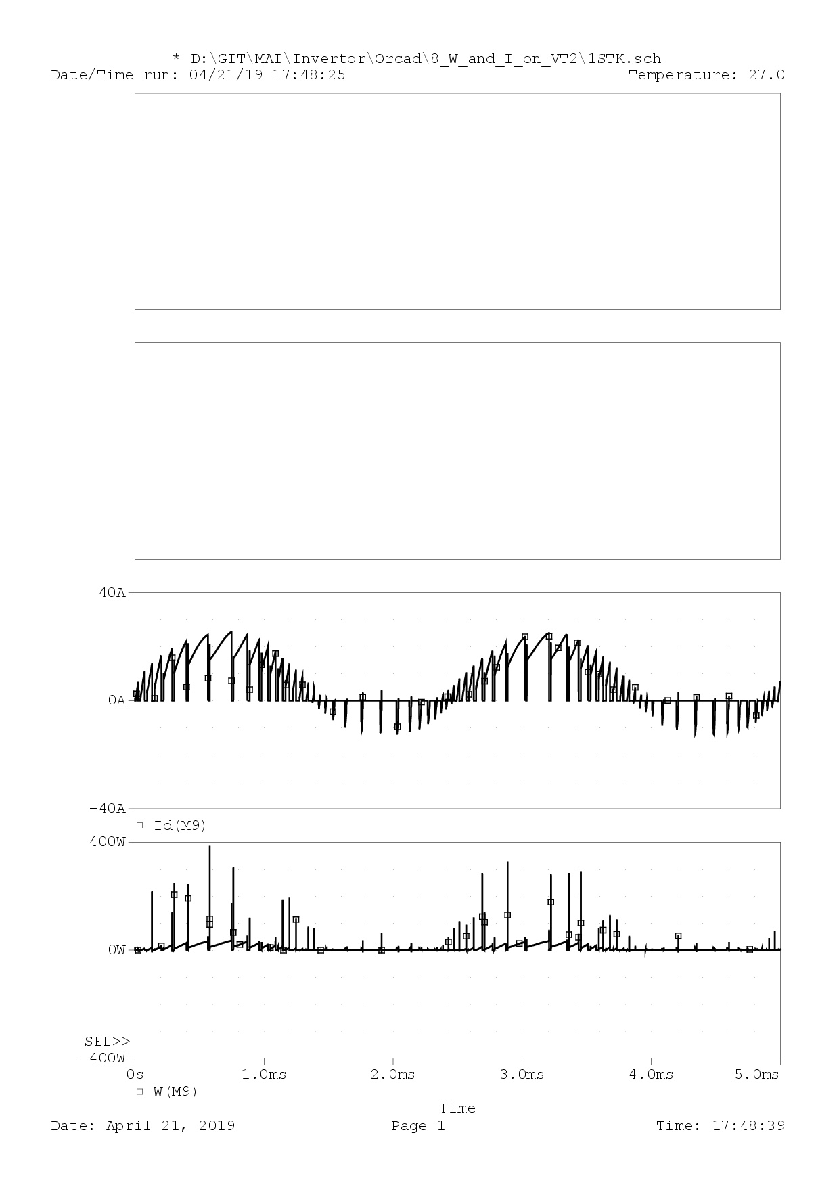
Time_diagramm/9_diodes.jpg
