fisher55rus/Invertor/Time_diagramm/9_no_diodes.jpg

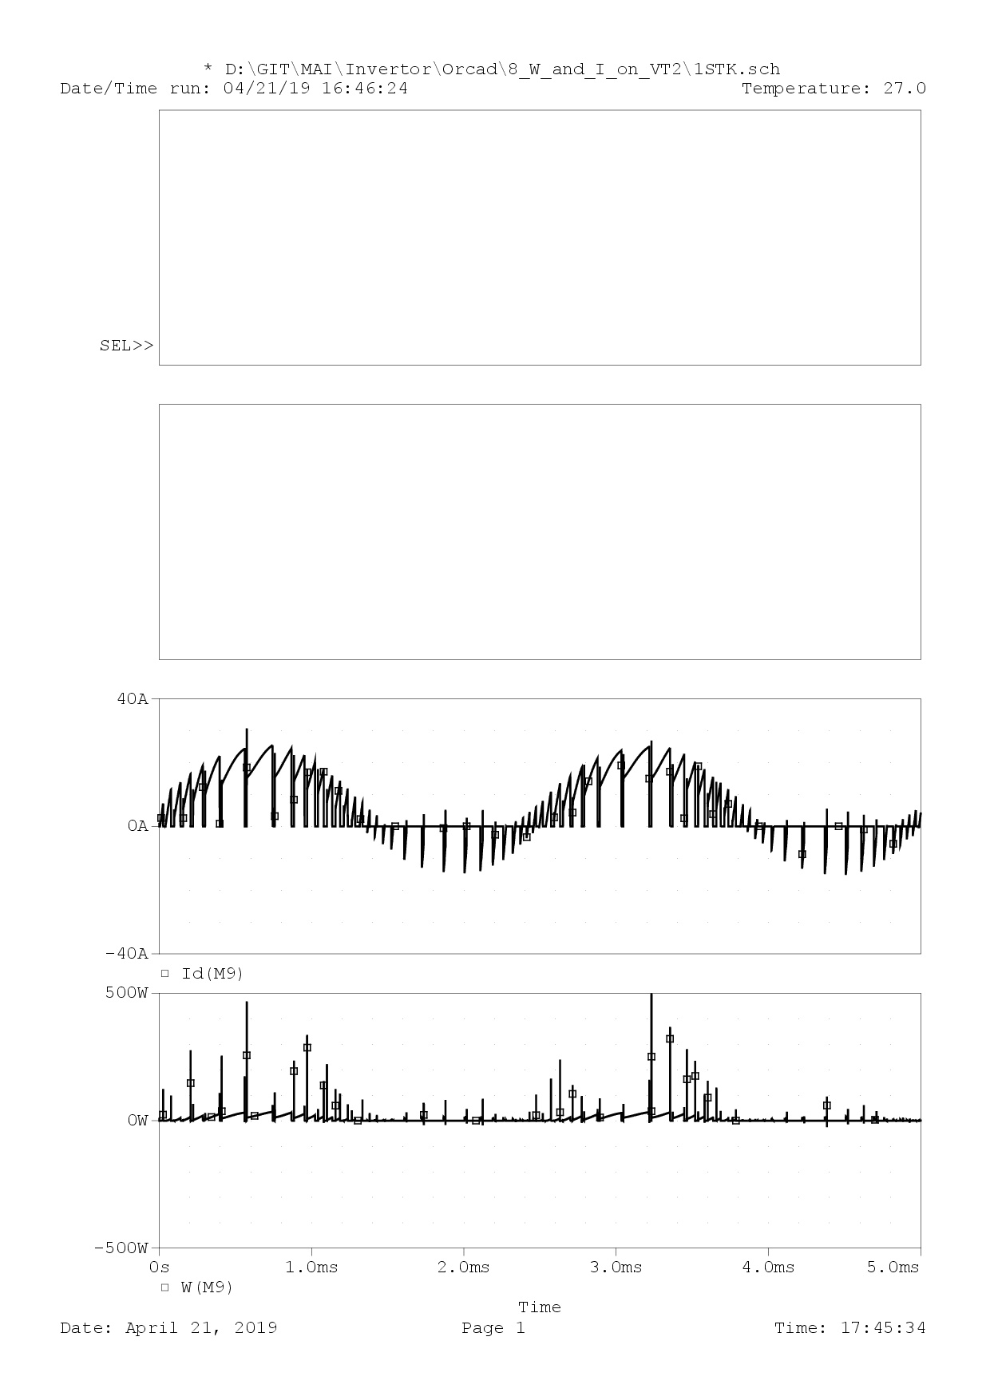
Time_diagramm/9_no_diodes.jpg
