fisher55rus/Invertor/Time_diagramm/10_stoika_diode.jpg

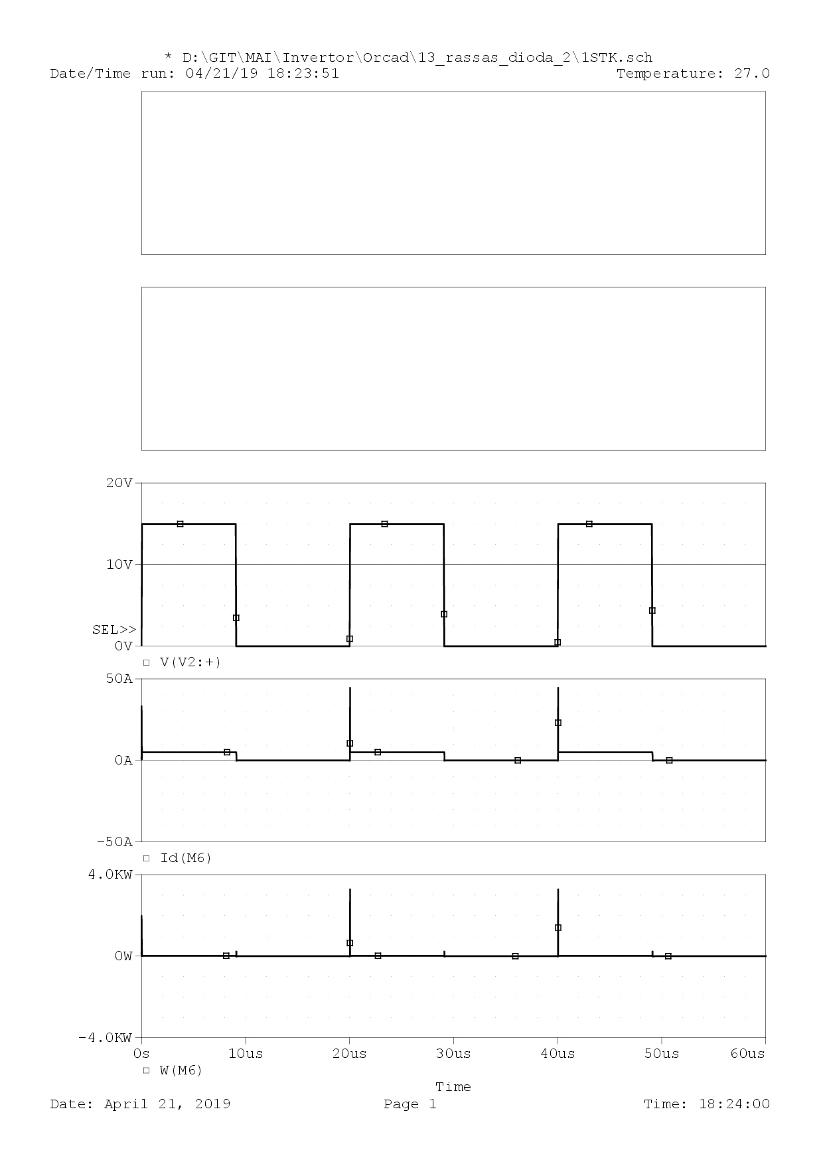
Time_diagramm/10_stoika_diode.jpg
