fisher55rus/Invertor/Time_diagramm/11_constant_current.jpg

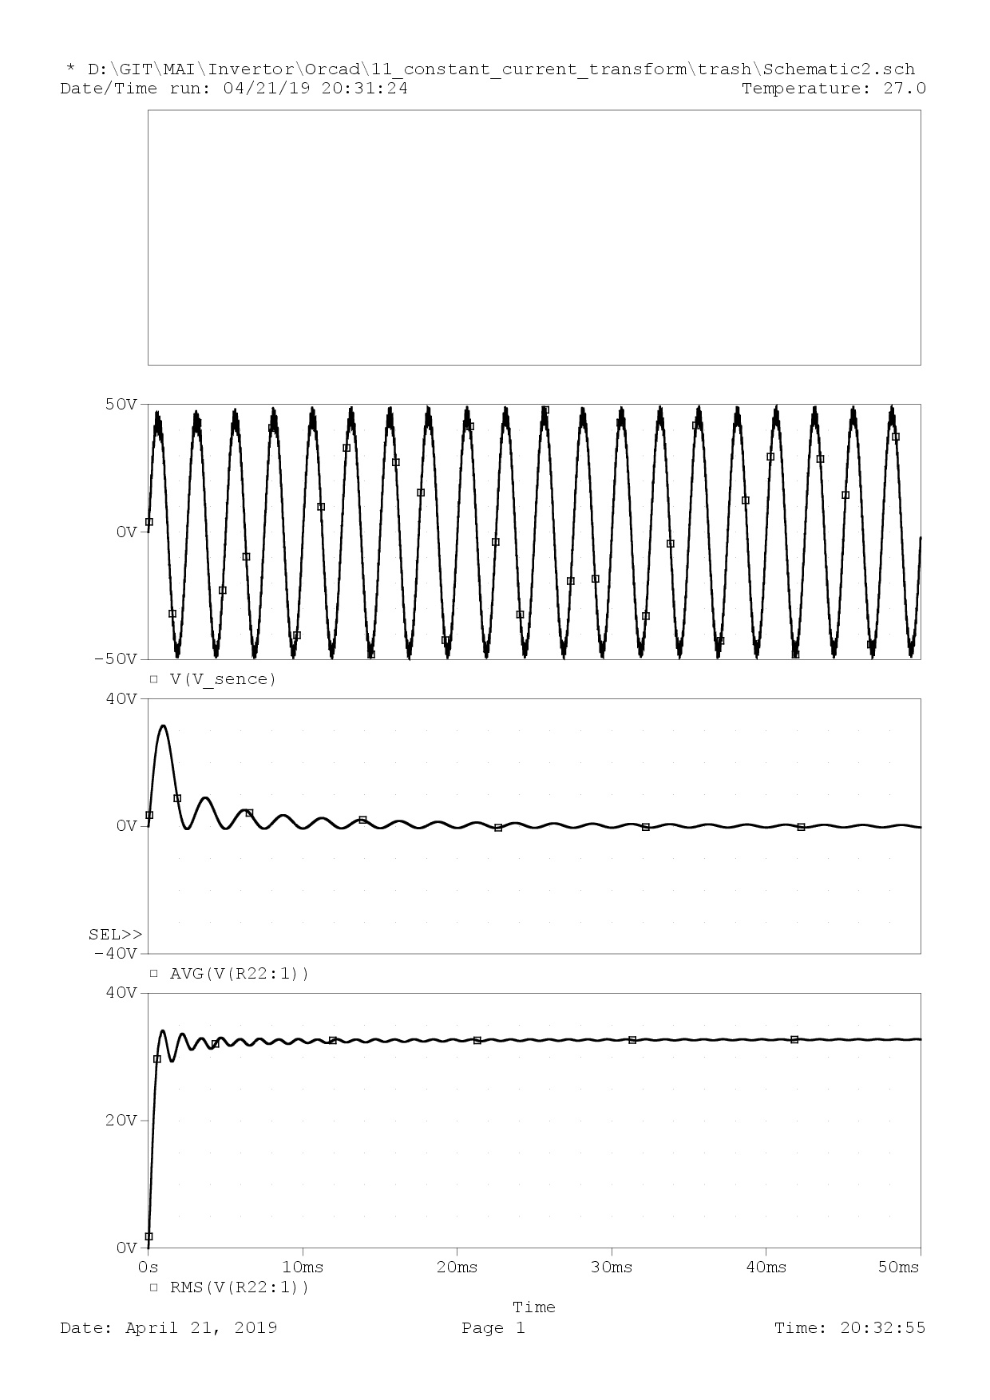
Time_diagramm/11_constant_current.jpg
