fisher55rus/Invertor/Time_diagramm/12_Fulovaya_schema.jpg

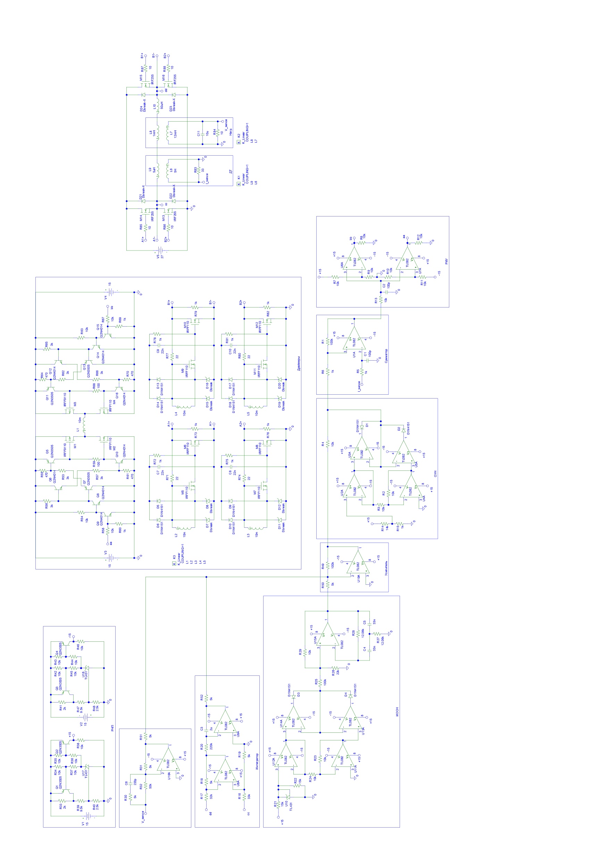
Time_diagramm/12_Fulovaya_schema.jpg
