fisher55rus/Invertor/Print/graphics.xlsx

Sheet: Варьирование Еп
Eп, В | 18 | 20 | 22 | 24 | 26 | 27 | 28 | 30 | 32 | 34 | 36
Ам., В | 48.9 | 49.3 | 49.4 | 49.4 | 49.5 | 49.5 | 49.5 | 49.5 | 49.5 | 49.5 | 49.5
AVG, В | 0.3 | 0.29 | 0.28 | 0.27 | 0.27 | 0.27 | 0.27 | 0.27 | 0.27 | 0.27 | 0.27
RMS, В | 33.2 | 33.3 | 33.5 | 33.5 | 33.7 | 33.7 | 33.7 | 33.7 | 33.7 | 33.7 | 33.7
КНИ, % | 3.4 | 3.2 | 3.2 | 3.2 | 3.2 | 3.3 | 3.3 | 3.4 | 3.5 | 3.6 | 3.7

Sheet: Варьирование Rн
Rн, Ом | 5 | 50 | 100 | 150 | 200 | 250 | 300 | 350 | 400 | 450 | 500
Ам., В | 40.9 | 48.9 | 49.9 | 50 | 50 | 50 | 50 | 50 | 50 | 50 | 50
AVG, В | 1.5 | 0.4 | 0.3 | 0.24 | 0.22 | 0.22 | 0.21 | 0.21 | 0.2 | 0.2 | 0.2
RMS, В | 30.5 | 33.9 | 34.1 | 34.2 | 34.2 | 34.3 | 34.3 | 34.3 | 34.3 | 34.3 | 34.3
КНИ, % | 9.7 | 3.3 | 2.9 | 2.8 | 2.8 | 2.8 | 2.8 | 2.8 | 2.8 | 2.8 | 2.8
