fisher55rus/Invertor/Orcad/8_W_and_I_on_VT2/Без диодов шотки.pdf

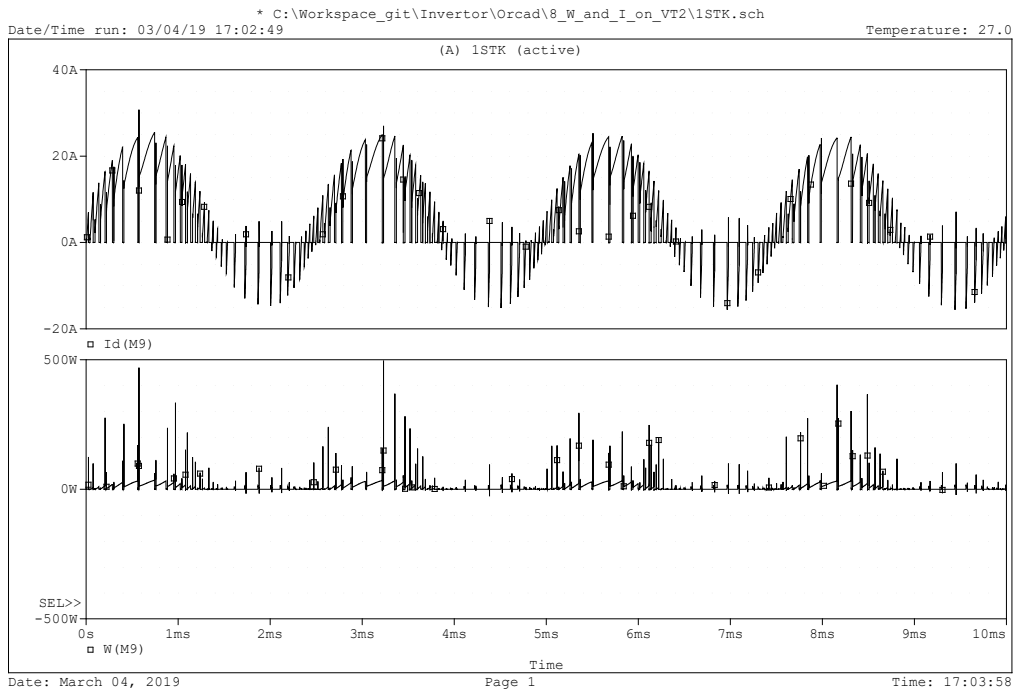
[picture p81: page 1]
Temperature: 27.0; Date: March 04, 2019; Page 1; Time: 17:03:58; (A) 1STK (active); Time; SEL>>

* C:\Workspace_git\Invertor\Orcad\8_W_and_I_on_VT2\1STK.sch

Date/Time run: 03/04/19 17:02:49
