fisher55rus/Invertor/Orcad/8_W_and_I_on_VT2/С диодами шотки.pdf

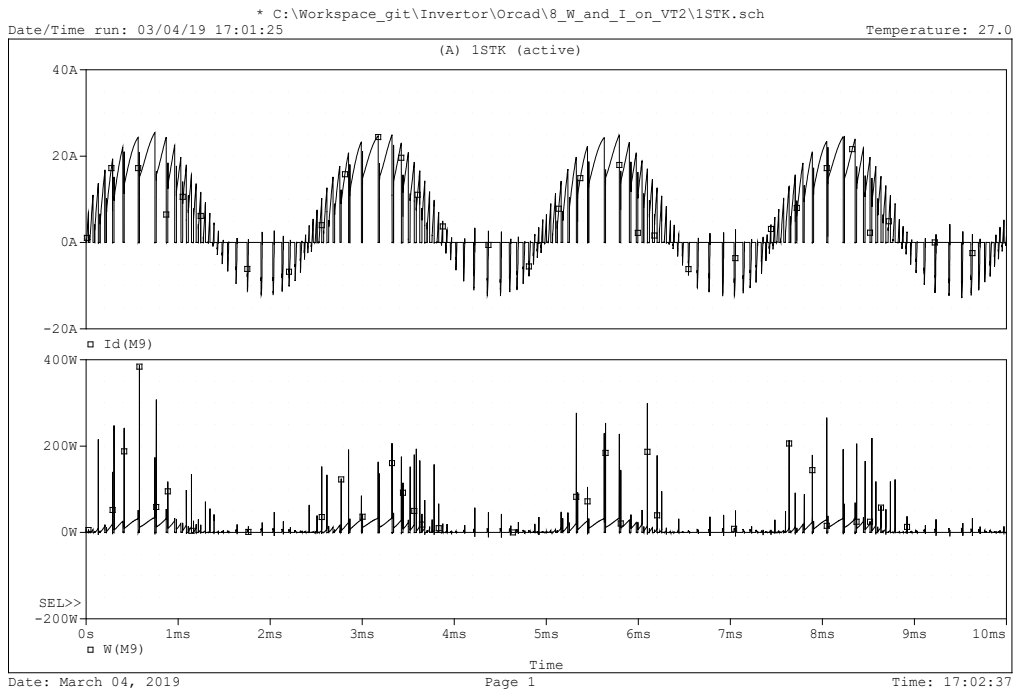
[picture p82: page 1]
Temperature: 27.0; Date: March 04, 2019; Page 1; Time: 17:02:37; (A) 1STK (active); Time; SEL>>

* C:\Workspace_git\Invertor\Orcad\8_W_and_I_on_VT2\1STK.sch

Date/Time run: 03/04/19 17:01:25
