fisher55rus/Invertor/template/schematic.pdf

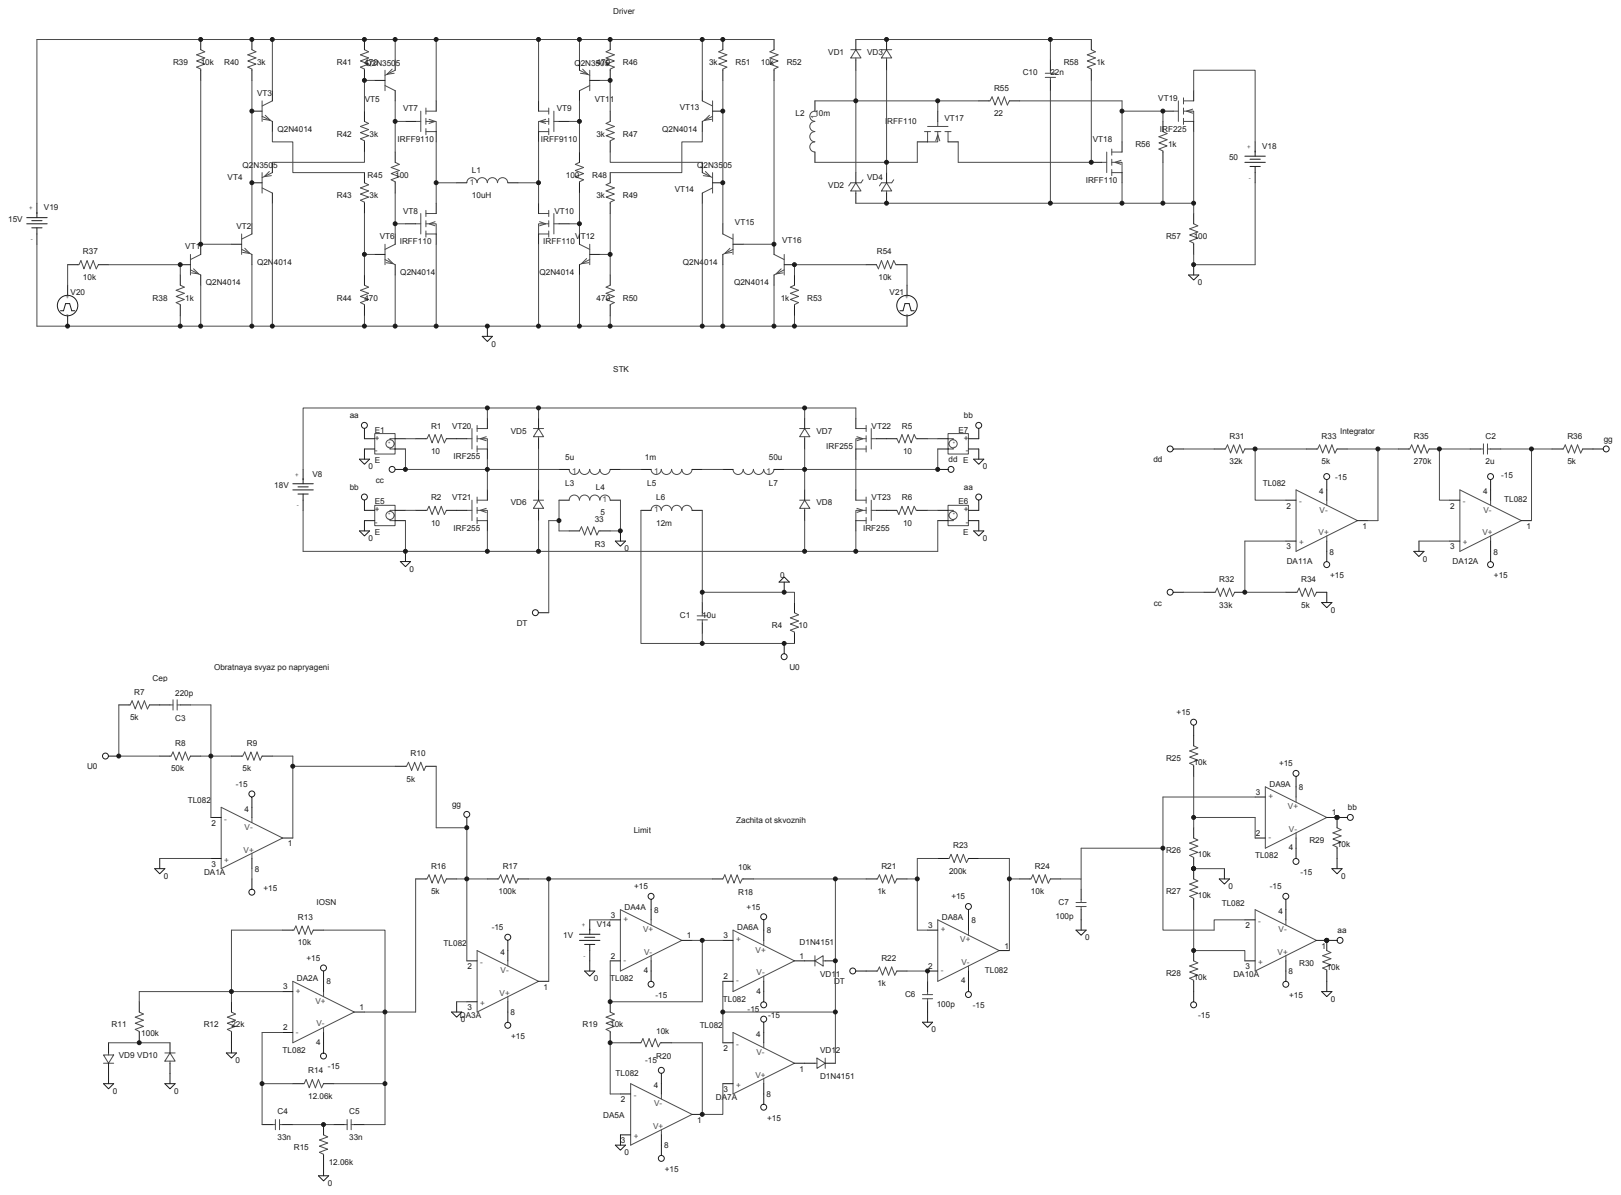
[picture p83: page 1]

Obratnaya svyaz po napryageni
