fisher55rus/Invertor/template/list_1.pdf

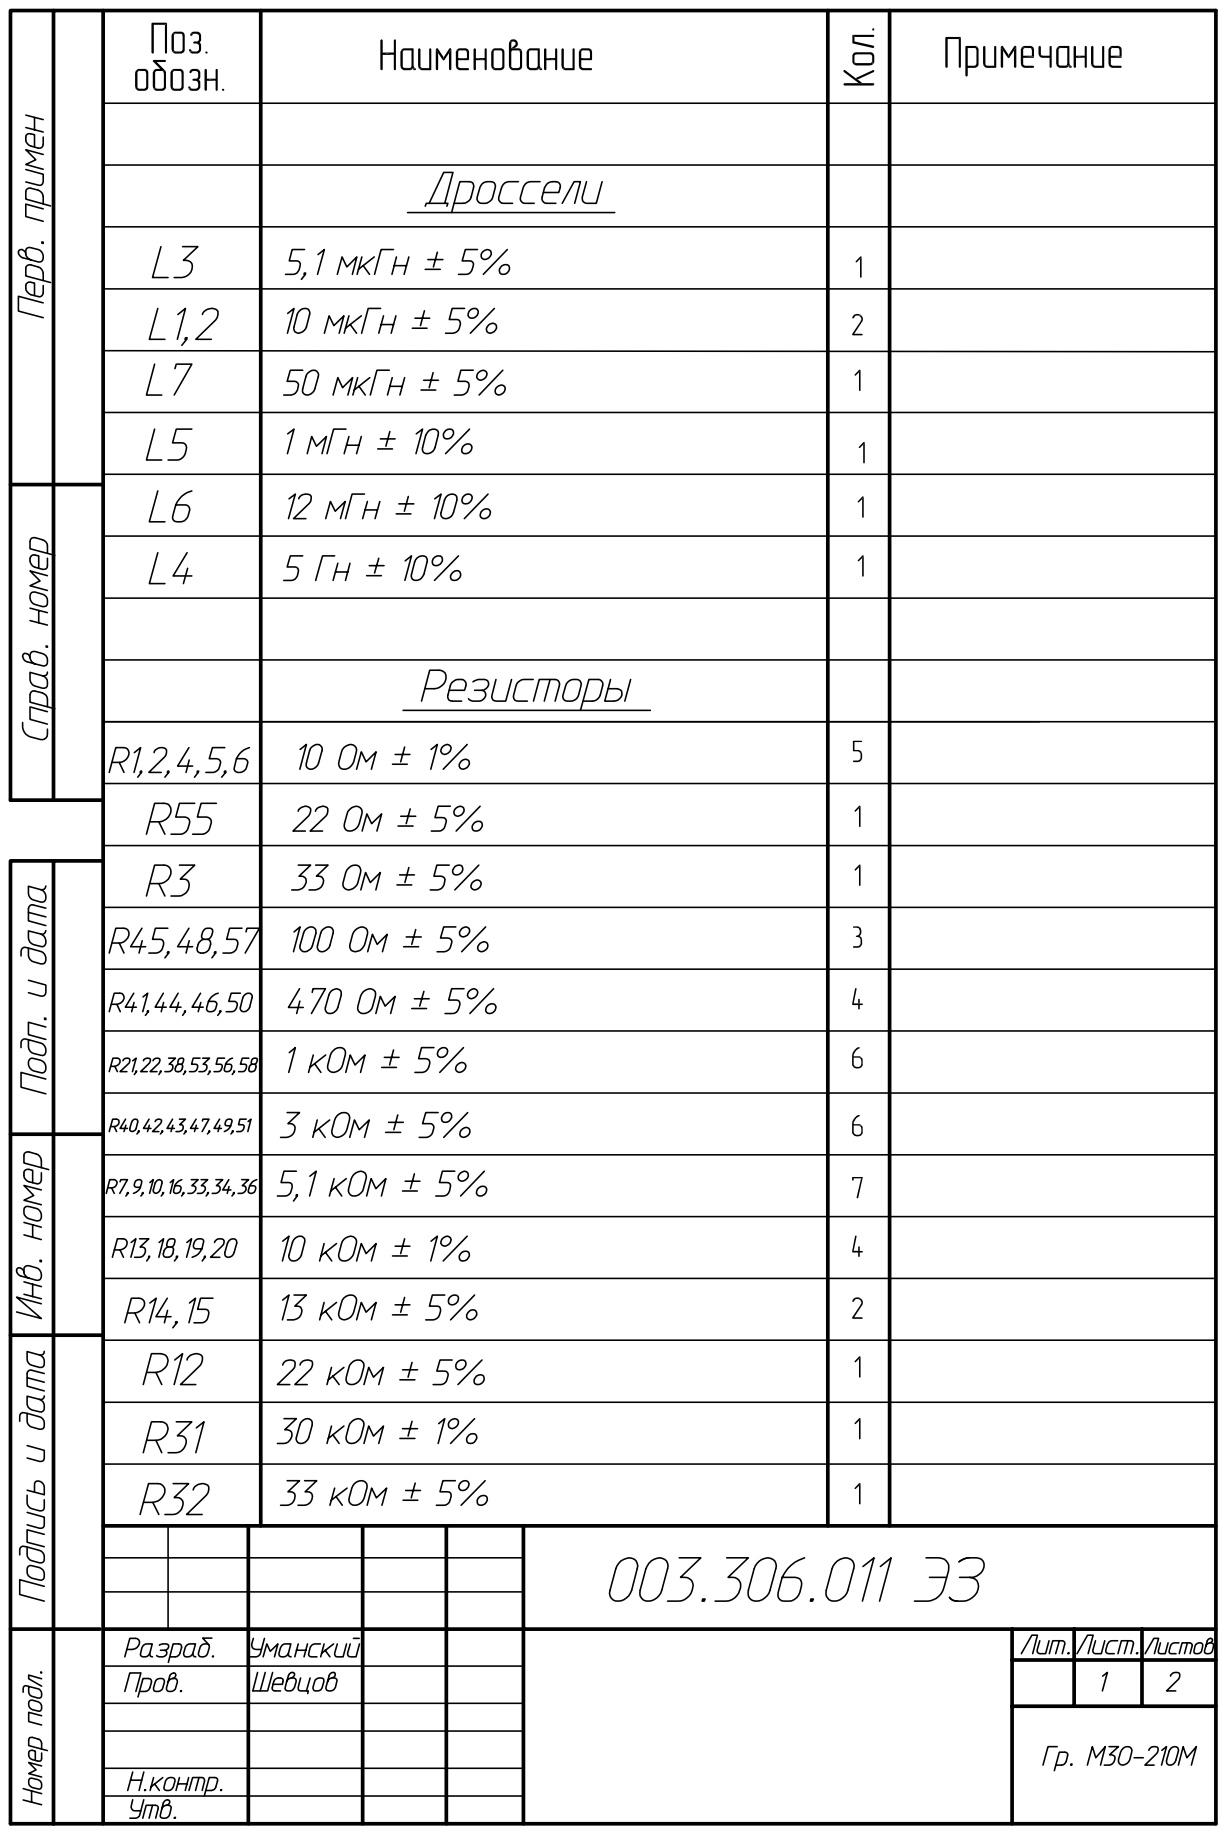
[picture p84: page 1]
