fisher55rus/Invertor/template/list_2.pdf

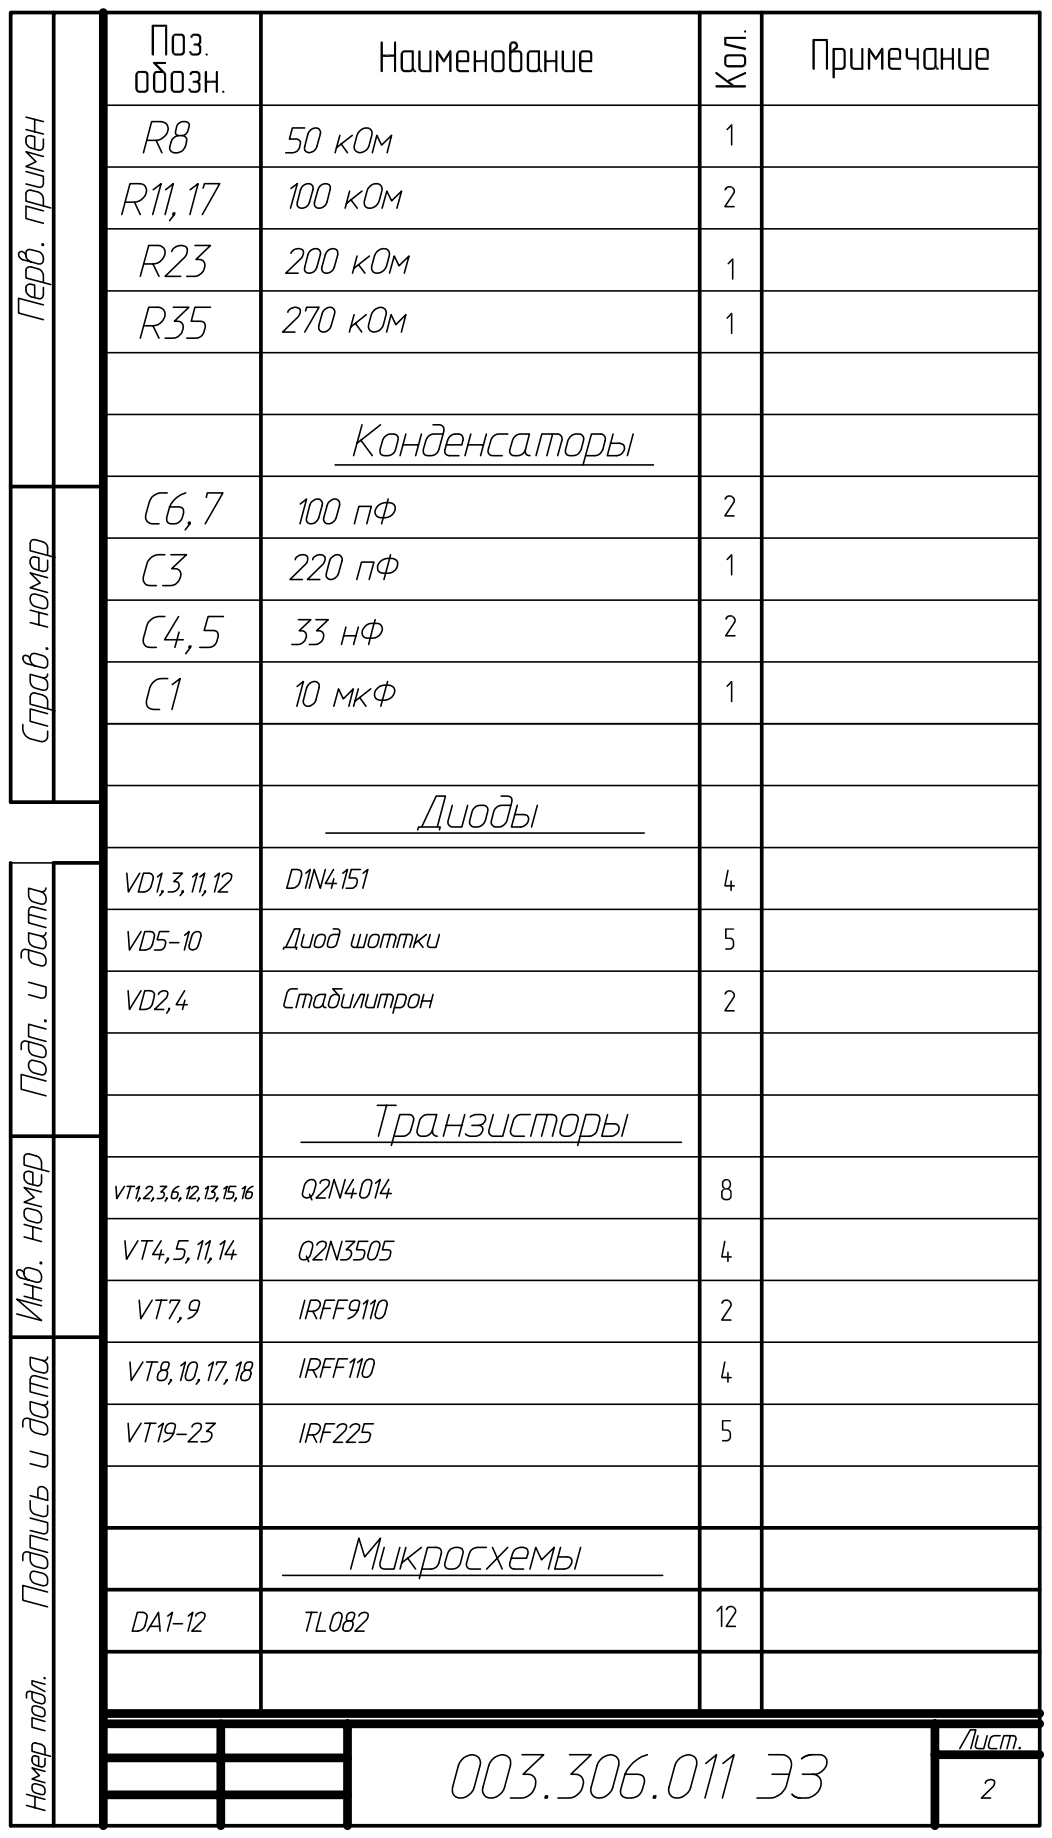
[picture p85: page 1]
