fisher55rus/Invertor/Orcad/Test_Var/Schematic2.cir

* C:\Workspace_git\Invertor\Orcad\Test_Var\Schematic2.sch

* Schematics Version 9.2
* Mon Mar 04 18:23:41 2019


.PARAM         Ep=27 Rvar=5 

** Analysis setup **
.tran 0ns 5ms 2.5ms 1.57u SKIPBP
.four 400 99 V([V_sence])
.OPTIONS ABSTOL=1uA
.OPTIONS ITL4=60
.OPTIONS RELTOL=0.01
.LIB "C:\Workspace_git\Invertor\Orcad\Test_Var\Schematic2.lib"


* From [PSPICE NETLIST] section of C:\Program Files\Orcad\PSpice\PSpice.ini:
.lib "C:\Program Files\Orcad\PSpice\UserLib\Mylib.lib"
.lib "nom.lib"
.inc "C:\Program Files\Orcad\PSpice\UserLib\Mylib.lib"

.INC "Schematic2.net"


.PROBE V(*) I(*) W(*) D(*) NOISE(*) 


.END
