fisher55rus/Invertor/Orcad/13_rassas_dioda_2/1STK.cir

* D:\GIT\MAI\Invertor\Orcad\13_rassas_dioda_2\1STK.sch

* Schematics Version 9.2
* Sun Apr 21 18:23:50 2019



** Analysis setup **
.tran 0ns 60us 0 0.53u SKIPBP
.OPTIONS ABSTOL=1uA
.OPTIONS ITL4=60
.LIB "D:\GIT\MAI\Invertor\Orcad\1_Power_cascade\1STK.lib"
.LIB "D:\GIT\MAI\Invertor\Orcad\13_rassas_dioda_2\1STK.lib"


* From [PSPICE NETLIST] section of d:\Program Files\Orcad\PSpice\PSpice.ini:
.lib "D:\Program Files\Orcad\PSpice\UserLib\OPA_2.lib"
.lib "D:\Program Files\Orcad\PSpice\UserLib\MyLib.lib"
.lib "nom.lib"

.INC "1STK.net"


.PROBE V(*) I(*) W(*) D(*) NOISE(*) 


.END
