fisher55rus/Invertor/Orcad/8_W_and_I_on_VT2/1STK.cir

* D:\GIT\MAI\Invertor\Orcad\8_W_and_I_on_VT2\1STK.sch

* Schematics Version 9.2
* Sun Apr 21 17:48:25 2019



** Analysis setup **
.tran 0ns 5m 0 1.57u SKIPBP
.OPTIONS ABSTOL=1uA
.OPTIONS ITL4=60
.LIB "D:\GIT\MAI\Invertor\Orcad\8_W_and_I_on_VT2\1STK.lib"


* From [PSPICE NETLIST] section of d:\Program Files\Orcad\PSpice\PSpice.ini:
.lib "D:\Program Files\Orcad\PSpice\UserLib\OPA_2.lib"
.lib "D:\Program Files\Orcad\PSpice\UserLib\MyLib.lib"
.lib "nom.lib"

.INC "1STK.net"


.PROBE V(*) I(*) W(*) D(*) NOISE(*) 


.END
