fisher55rus/Invertor/Orcad/4_Rele_pit/RNP.cir

* D:\GIT\MAI\Invertor\Orcad\4_Rele_pit\RNP.sch

* Schematics Version 9.2
* Fri Apr 12 20:02:26 2019



** Analysis setup **
.tran 0ns 20m 0 1.57u SKIPBP
.LIB "D:\GIT\MAI\Invertor\Orcad\2_Sinus_generator\Sinus_generator.lib"


* From [PSPICE NETLIST] section of d:\Program Files\Orcad\PSpice\PSpice.ini:
.lib "D:\Program Files\Orcad\PSpice\UserLib\OPA_2.lib"
.lib "D:\Program Files\Orcad\PSpice\UserLib\MyLib.lib"
.lib "nom.lib"

.INC "RNP.net"


.PROBE V(*) I(*) W(*) D(*) NOISE(*) 


.END
