fisher55rus/Invertor/Orcad/3_Limit/Limit.cir

* D:\GIT\MAI\Invertor\Orcad\3_Limit\Limit.sch

* Schematics Version 9.2
* Mon Apr 08 17:53:41 2019



** Analysis setup **
.tran 0ns 60m 0 1.57u SKIPBP
.LIB "D:\GIT\MAI\Invertor\Orcad\2_Sinus_generator\Sinus_generator.lib"


* From [PSPICE NETLIST] section of d:\Program Files\Orcad\PSpice\PSpice.ini:
.lib "D:\Program Files\Orcad\PSpice\UserLib\OPA_2.lib"
.lib "D:\Program Files\Orcad\PSpice\UserLib\MyLib.lib"
.lib "nom.lib"

.INC "Limit.net"


.PROBE V(*) I(*) W(*) D(*) NOISE(*) 


.END
