fisher55rus/Invertor/(commit log)

2019-03-04 Добавлена библиотека Mylib
    Копировать в Userlib
    [OPA_1.sch, OPA_2.sch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]
2019-03-04 Добавлен силовой каскад
    [1STK.sch]
2019-03-04 Добавлен генератор опорного синуса
    [SG_prec.sch, Sinus_generator.sch]
2019-03-04 Добавлен ограничитель уровня напряжения
    [Limit.sch]
2019-03-04 Добавлено реле напряжения питания
    [RNP.sch]
2019-03-04 Добавлены системы с замкнутой обратной связью
    [1STK.sch]
2019-03-04 Обоснование установки шунтирующих диодов
    Добавлена схема, результаты моделирования в PDF.
    Силовой транзистор заменен на IRF540.
    [1STK.sch]
2019-03-04 Варьирование Е питания
    [1STK.sch]
2019-03-04 Варьирование R нагрузки
    [1STK.sch]
2019-03-04 Схема для корректного параметрического моделирования
    [Schematic2.sch]
2019-03-04 Добавлена схема с интегратором в обратной связи
    [Schematic2.sch]
2019-03-11 Моделирование стойки без шотки
    [1STK.sch]
2019-03-11 Моделирование стойки с шотки
    [1STK.sch]
2019-03-11 Добавлен драйвер
    Моделирование без стабилитронов.
    При coupling 0.9 говно на затвор-истоке СТК
    [Schematic2.sch]
2019-03-11 Моделирование драйвера со стабилитроном
    Избавились от говна на затвор-истоке СТК при coupling 0.9
    [Schematic2.sch]
2019-03-11 Моделирование первичной цепи драйвера
    [Schematic2.sch]
2019-03-24 Начата работа над отчетом
    - Сформирована структура отчета
    - Сформулирована тема работы
2019-03-24 Введение
2019-03-30 Структурная схема инвертора
2019-03-30 Функциональная схема СК
2019-03-30 Функциональная схема СУЗ без описания
2019-04-08 Чуть-чуть поработал
    [1STK.sch, Limit.sch]
2019-04-11 СК, список литературы
    [1STK.sch]
2019-04-12 Можно приступать к моделированию
    [Limit.sch, RNP.sch, SG_prec.sch, SG_prec_only.sch, Schematic2.sch, Sinus_generator.sch]
2019-04-13 Остановился на ведении звена коррекции
    [1STK.sch, test.sch]
2019-04-28 Доделан отчет
    [1STK.sch, Full_clear.sch, Fulovaya.sch, Schematic2.sch, graphics.xlsx, test.sch]
